Aapjedotinfo/esp32ct/hardware/esp32ct-revc/esp32ct-revc.pdf

1 | 2 | 3 | 4 | 5 | 6 | 7 | 8

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
Size: A3 | Rev: C | F Date: 2026-09-25
KiCad E.D.A. 10.0.6 | Id: 1/7

## Title: esp32ct rev C — Overzicht en ESP32

File: esp32ct-revc.kicad_sch

Sheet: /

Ontwerp. Basis: het huidige bord plus de wijzigingen van 22-09-2026.

Waarden met (?) zijn NIET van het bord afgelezen - zie OPEN PUNTEN.

Gegenereerd door gen_sch.py - pas dat script aan, niet dit bestand.

P1-uitgang naar laadpaal Bestand: p1_uit.kicad_sch Deurbel en watermeter Bestand: bel_water.kicad_sch P1 slimme meter Bestand: p1.kicad_sch CT-kanalen 1-16 Bestand: ct_kanalen.kicad_sch Multiplexer (HW-178) Bestand: mux.kicad_sch

Voeding en VBIAS Bestand: voeding.kicad_sch GND 1 | RST/EN 2 | NC 3

IO36/SVP 4
IO39/SVN 5
IO26 6
IO35/ADC1_7 7
IO18 8
IO33 9
IO19 10
IO34/ADC1_6 11
IO23 12
IO14 13
IO05 14 NC 15

3V3 16
IO09/SD2 17
IO13 18 CMD 19

IO10/SD3 20

TXD | 21 GND | 22 RXD | 23
IO27 | | 24
IO22 | | 25
IO25 | | 26
IO21 | | 27
IO32 | | 28
IO17 | | 29
IO12_(strap) | | 30
IO16 | | 31
IO04 | 32 GND | 33
IO00 | | 34
VCC_(USB) | | 35
IO02 | | 36
TD0 | | 37
SD1 | | 38
SD0 | 39 CLK | 40 U1MH-ET Live D1 mini ESP32 GND

GND WATER_PULS MUX_S1 BEL_IN

P1_RX BEL_HUIS

SIG_MUX1 P1_RTS MUX_S2 | P1OUT_RTS P1OUT_TX +3V3 | MUX_S3 BEL_GARAGE MUX_S0 | GND +5V

esp32ct rev C — 16 CT-kanalen, P1 in en uit, watermeter, deurbel ONTWERP. Basis is het huidige bord; de wijzigingen staan hieronder. De pinbezetting komt uit de draaiende firmware (esp32ct.yaml), met

twee wijzigingen: P1_RTS van GPIO19 naar GPIO23, en mux S1 van GPIO12 naar GPIO4. Nieuw zijn GPIO16 en GPIO17 voor de P1-uitgang. Geen strapping pins: GPIO0, 2, 5, 12 en 15 hangen nergens aan. Een hoge GPIO12 bij het opstarten zet de flash op 1,8 V en dan
start de module niet. WIJZIGINGEN t.o.v. het huidige bord - 16 CT-kanalen in plaats van 22; de tweede multiplexer vervalt. Die mat alleen de laadpaal en had een defecte VBIAS-rail. - de mux is een HW-178-breakout op twee female headers. - per kanaal een jumper IN SERIE met de burden, zodat een klem met eigen burden kan zonder de weerstand weg te knippen. - alles op schroefklem behalve de twee RJ12's. - de relais zitten op een los Arduino-relaisbordje (J4/J5). Die zijn actief-laag: de firmware heeft inverted: true nodig. - nieuw: P1-uitgang naar de laadpaal (blad 7). - P1_RTS op GPIO23 (was 19), mux S1 op GPIO4 (was 12). GPIO35 komt vrij.

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
## Title: esp32ct rev C — Voeding en VBIAS

File: voeding.kicad_sch

Sheet: /Voeding en VBIAS/

Ontwerp. Basis: het huidige bord plus de wijzigingen van 22-09-2026.

Waarden met (?) zijn NIET van het bord afgelezen - zie OPEN PUNTEN.

Gegenereerd door gen_sch.py - pas dat script aan, niet dit bestand.

F1
1A | C2
100n (?) 1

1

2

2

J1+5V | extern | R1
10k (?) | C1 100u (?)

#FLG1 PWR_FLAG

#FLG2 PWR_FLAG

R2

10k (?) | C3
10u (?) | 1OUT | 1
1IN- 2

1IN+ 3

V- 4

2IN+ 5

2IN- 6

2OUT | 7
V+ | 8 U2
LM358 +5V_IN | +5V GND | +5V +5V | GND | +5V +3V3 | GND | GND GND | GND
GND | +3V3

VBIAS

voedingsspanning van de opamp

niet nagekeken (?) | VBIAS — de middenrail van 1,65 V De CT's leveren wisselstroom. De ADC van de ESP32 kan alleen 0-3,3 V meten, dus wordt het hele signaal opgetild naar het midden van dat bereik. Elke burden-weerstand hangt met één been aan deze rail. Dat maakt VBIAS ook meteen de verdachte in het mux2-probleem: als de

rail de ingangen van mux2 niet bereikt, meet die mux niets zinnigs. De tweede opamp van de LM358 is ongebruikt. OPEN PUNTEN op dit blad - de deelweerstanden en condensatoren zijn NIET van het bord

afgelezen; 10k/10k geeft 1,65 V maar de echte waarden zijn onbekend - of de LM358 op 3,3 V of op 5 V staat is niet nagekeken - of de ongebruikte tweede opamp netjes is afgesloten is onbekend - de 5 V-buffercondensatoren zijn aangenomen, niet geteld

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
## Title: esp32ct rev C — Multiplexer (HW-178)

File: mux.kicad_sch

Sheet: /Multiplexer (HW-178)/

Ontwerp. Basis: het huidige bord plus de wijzigingen van 22-09-2026.

Waarden met (?) zijn NIET van het bord afgelezen - zie OPEN PUNTEN.

Gegenereerd door gen_sch.py - pas dat script aan, niet dit bestand.

C0 1 | C1 2 | C2 3 | C3 4 | C4 5 | C5 6 | C6 7 | C7 8 | C8 9 | C9 10 | C10 11 | C11 12 | C12 13 | C13 14 | C14 15 | C15 16
SIG | 17
EN | 18
S0 | 19
S1 | 20
S2 | 21
S3 | 22
VCC | 23 GND | 24 U3HW-178 (CD74HC4067) | MUX_S3 CT1 CT4 CT2 CT5 CT3 CT16 CT6 CT9 CT7 CT8

SIG_MUX1 GND

CT10 | MUX_S0 CT11 | MUX_S1 CT12 | MUX_S2 CT13 | +3V3 CT14 | GND

CT15

Een multiplexer, zestien kanalen - en dat is met opzet Het vorige bord had er twee, die samen de adreslijnen S0-S3 deelden. Dat werkte alleen met precies EEN cd74hc4067-hub in de firmware: bij twee hubs raakte de interne cache van elk van beide verouderd

zodra de ander schakelde, en landden metingen op een verkeerd (vaak zwevend) kanaal. Dat gaf fantoomwaardes van meerdere kW. De tweede mux is hier vervallen. Hij mat alleen de laadpaal, en die wordt voortaan aangestuurd via de nagebootste P1-uitgang op blad 7. Daarmee verdwijnt ook het VBIAS-probleem dat mux2 onbruikbaar maakte. GPIO35 komt daarmee vrij.

U3 is geen chip maar een VOETJE voor het HW-178-breakout Het breakout steekt plat met rechte pinnen in twee female strips: 1x16 voor C0-C15 en 1x8 voor SIG..GND, op 15,24 mm hart-op-hart. Maten uit SparkFun's BOB-09056, waar het HW-178 een kloon van is. De pinnummers van U3 zijn die van het voetje (footprint HW178_socket), NIET die van de CD74HC4067-chip. Zet hier nooit een DIP- of SOIC-footprint onder: dan klopt geen pin en hangt VCC aan GND. EN ligt vast aan massa: de mux staat permanent aan.

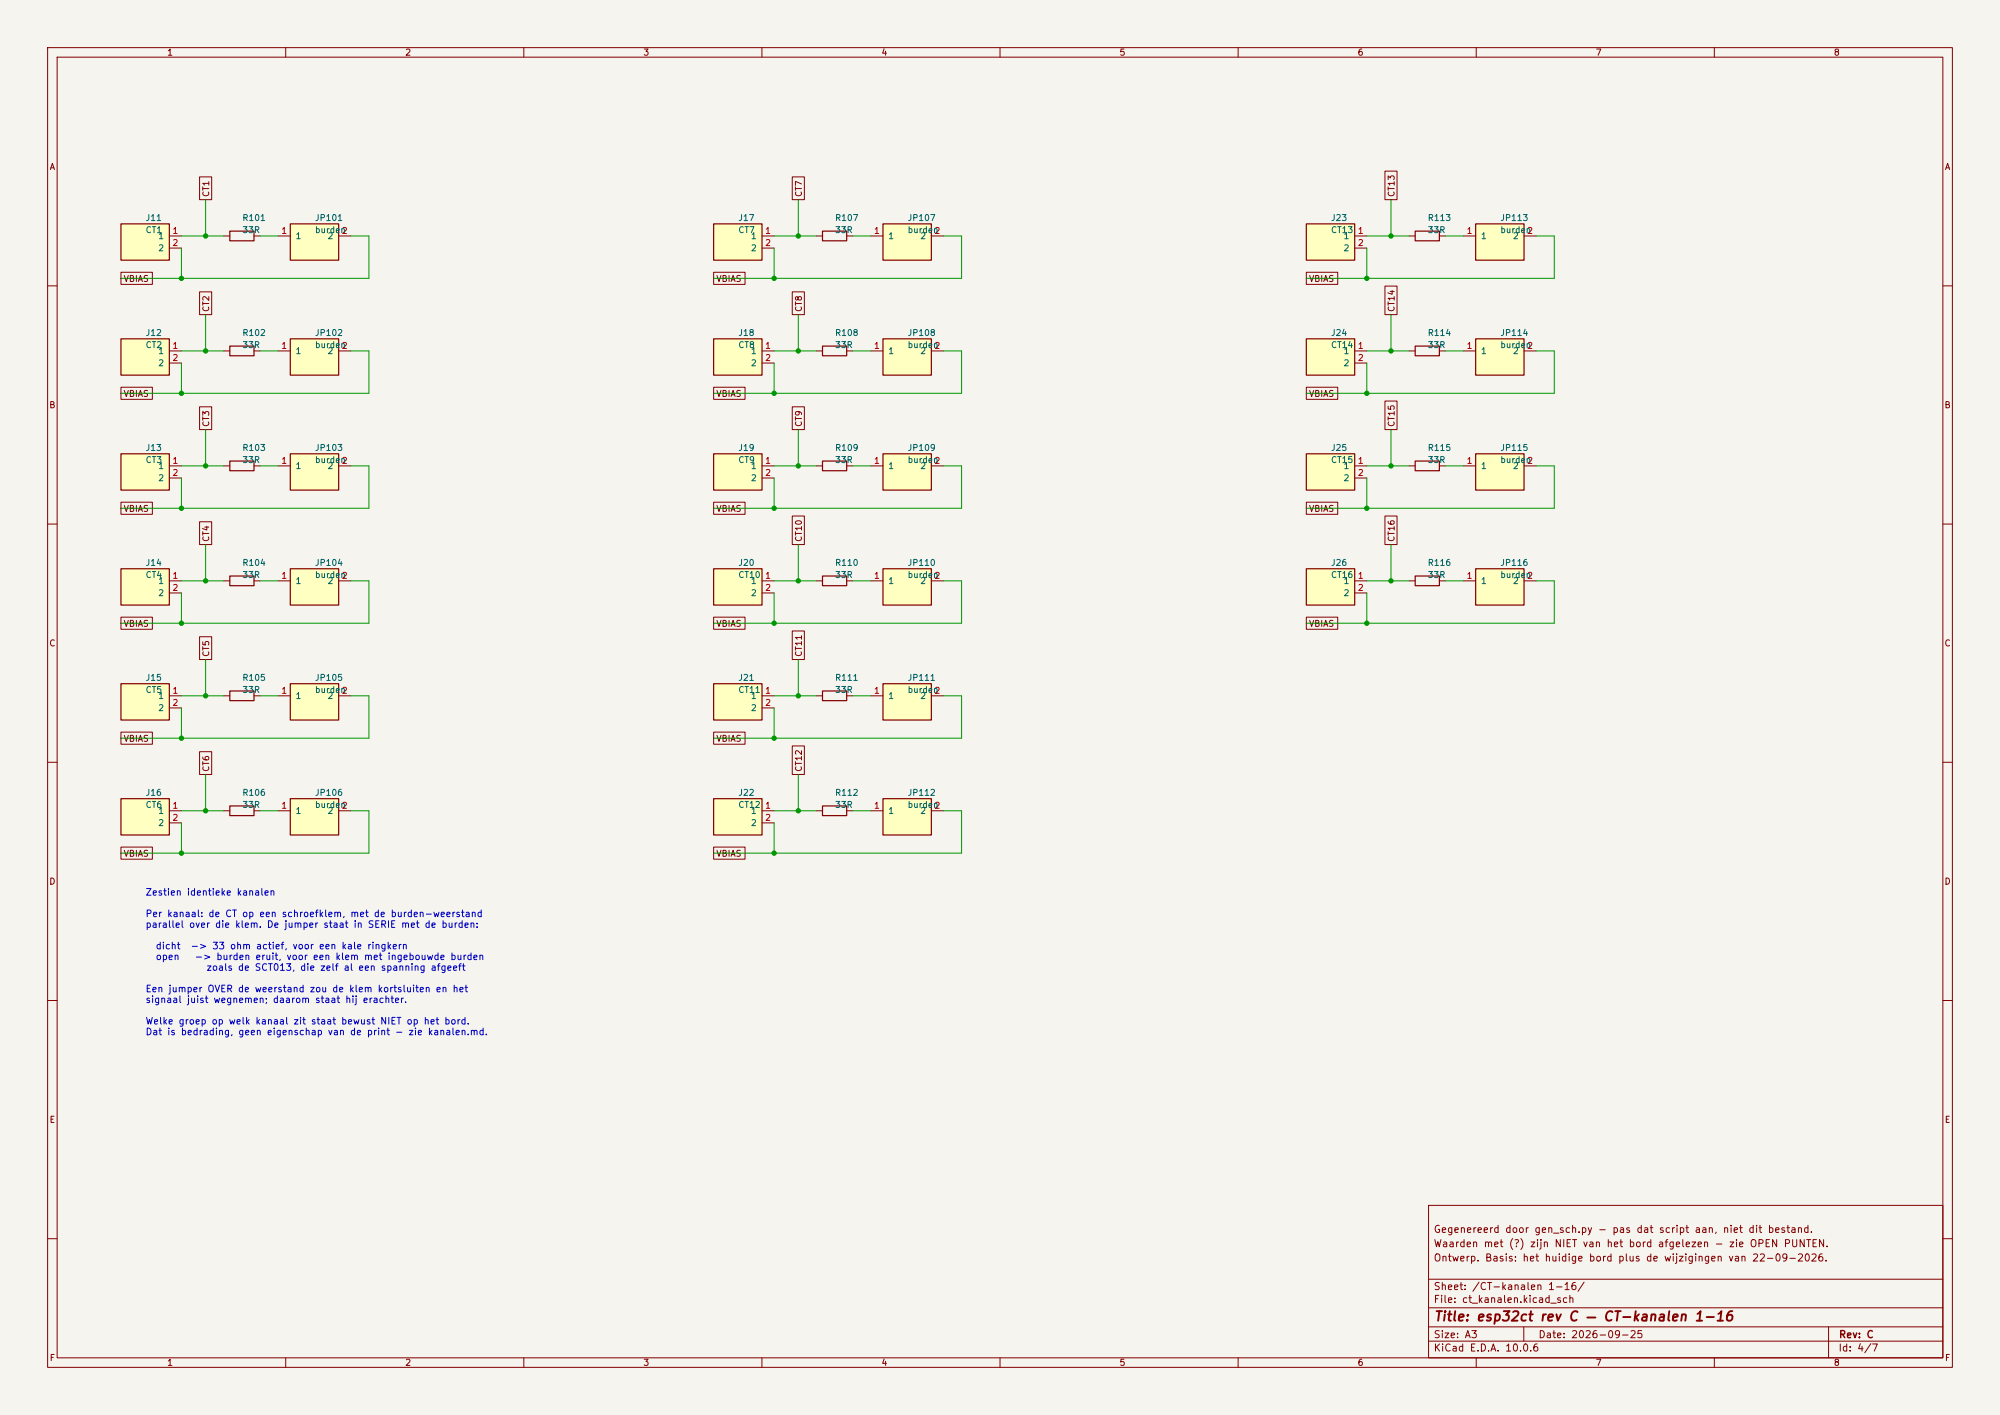
[picture p5: page 4]

Zestien identieke kanalen Per kanaal: de CT op een schroefklem, met de burden-weerstand

parallel over die klem. De jumper staat in SERIE met de burden: dicht -> 33 ohm actief, voor een kale ringkern

zoals de SCT013, die zelf al een spanning afgeeft Een jumper OVER de weerstand zou de klem kortsluiten en het signaal juist wegnemen; daarom staat hij erachter. Welke groep op welk kanaal zit staat bewust NIET op het bord. Dat is bedrading, geen eigenschap van de print - zie kanalen.md.

Gegenereerd door gen_sch.py - pas dat script aan, niet dit bestand.
Waarden met (?) zijn NIET van het bord afgelezen - zie OPEN PUNTEN.
Ontwerp. Basis: het huidige bord plus de wijzigingen van 22-09-2026.

Sheet: /CT-kanalen 1-16/
File: ct_kanalen.kicad_sch
Title: esp32ct rev C — CT-kanalen 1-16

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
## Title: esp32ct rev C — P1 slimme meter

File: p1.kicad_sch

Sheet: /P1 slimme meter/

Ontwerp. Basis: het huidige bord plus de wijzigingen van 22-09-2026.

Waarden met (?) zijn NIET van het bord afgelezen - zie OPEN PUNTEN.

Gegenereerd door gen_sch.py - pas dat script aan, niet dit bestand.

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
J2RJ12 naar slimme meter | R3
10k (?) | C

1 B

2

E | 3 Q1BC547 | (?) | R4

10k (?) P1_RTS GND

P1_DATA GND

P1_DATA | GND | +3V3 | P1_RX | P1-poort van de slimme meter De meter zendt inverted TTL op een open-collector uitgang. Een NPN
| | | | draait het signaal om en tilt het naar 3,3 V, zodat de UART van de ESP32 het kan lezen (GPIO18).
| | | | P1_RTS (GPIO23) vraagt de meter om te zenden: hoog is elke seconde een telegram. De firmware heeft dit als request_pin. OPEN PUNTEN op dit blad - de inverter is de gangbare schakeling, maar het type transistor en de weerstandswaarden zijn NIET van het bord afgelezen - of P1_RTS rechtstreeks aan GPIO23 mag of via een

niveauomzetter naar 5 V, is niet nagekeken - of de meter het bord voedt via RJ12 pin 1 is niet nagekeken; hier is uitgegaan van de externe 5 V op J1

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
## Title: esp32ct rev C — Deurbel en watermeter

File: bel_water.kicad_sch

Sheet: /Deurbel en watermeter/

Ontwerp. Basis: het huidige bord plus de wijzigingen van 22-09-2026.

Waarden met (?) zijn NIET van het bord afgelezen - zie OPEN PUNTEN.

Gegenereerd door gen_sch.py - pas dat script aan, niet dit bestand.

1

1

2

2

J4
naar relaisbordje

R18
10k 1

1

2

2

J3watermeter-sensor 1

1

2

2

J9watermeter-sensor

1

1

2

2

J6

# deurbelknop 1

1

2

2

J5
naar | relaisbordje +5V WATER_PULS GND
GND | +3V3 WATER_PULS

# GND +5V GND

BEL_HUIS BEL_GARAGE BEL_IN Deurbel De relais zitten niet meer op dit bord. J4 en J5 gaan met vier draden

naar een standaard Arduino-relaisbordje met twee kanalen: J4-1 +5V | -> VCC van het relaisbordje
J4-2 GND | -> GND
J5-1 BEL1 (huis) | GPIO33 -> IN1
J5-2 BEL2 (garage) GPIO25 -> IN2 De beltrafo (6 V AC) en de twee bellen komen op de schroefklemmen van

dat relaisbordje: trafo naar COM van beide relais, NO naar de bel, en
de retour van beide bellen rechtstreeks terug naar de trafo. De deurbelknop (J6) blijft hier: een gewoon maakcontact in de deur, dat rechtstreeks aan GPIO26 hangt met de interne pull-up. Watermeter: inductieve naderingsschakelaar, 5 Vdc NPN, normally open, 4 mm schakelafstand. Bruin = +5 V, blauw = GND, zwart = de open-collector uitgang (op J3 pin 2). R18 trekt de uitgang op naar 3,3 V. Omdat de sensor alleen naar massa schakelt, komt er nooit 5 V op GPIO32 - een deler is dus niet nodig. De sensor zelf draait wel op 5 V. De firmware gooit sinds 14-09-2026 alles boven 30 L/min weg; dat ving een klapperende sensor af, geen hardwarewijziging.

LET OP - de firmware moet mee veranderen De gangbare relaisbordjes zijn ACTIEF-LAAG: het relais komt op als IN

naar massa gaat. In esp32ct.yaml staan de switches op GPIO33 en GPIO25 nu zonder inverted, en een ESP32-pin is laag tijdens het opstarten. Zonder inverted: true gaat de bel dus bij elke reboot. En: de logicakant van zo'n bordje hangt aan 5 V, de ESP32 stuurt maar 3,3 V. Test of het relais netjes afvalt als IN op 3,3 V staat. Blijft het hangen of klappert het, voed dan VCC van het relaisbordje uit 3,3 V en de spoelen (JD-VCC) uit 5 V.

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
## Title: esp32ct rev C — P1-uitgang naar laadpaal

File: p1_uit.kicad_sch

Sheet: /P1-uitgang naar laadpaal/

Ontwerp. Basis: het huidige bord plus de wijzigingen van 22-09-2026.

Waarden met (?) zijn NIET van het bord afgelezen - zie OPEN PUNTEN.

Gegenereerd door gen_sch.py - pas dat script aan, niet dit bestand.

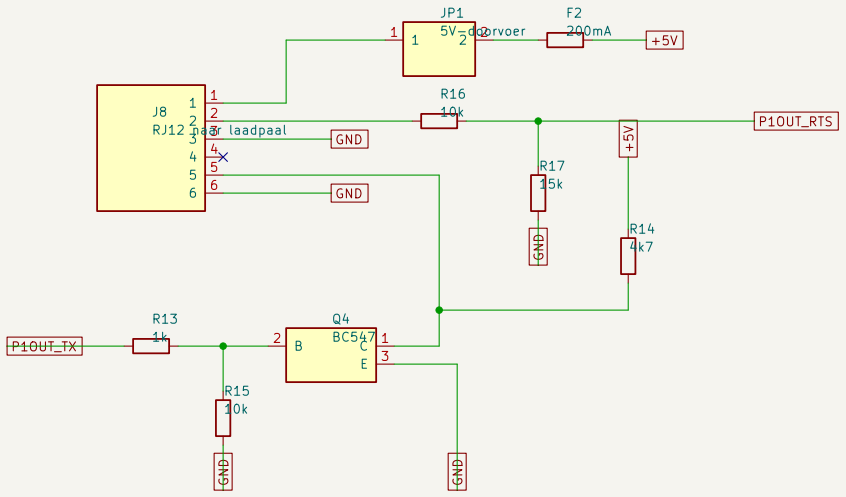
[picture p6: figure]
J8RJ12 naar laadpaal; JP1 5V-doorvoer R15; GND; P1OUT_RTS GND; +5V GND

P1OUT_TX | GND | OPEN PUNTEN - GPIO16/17 zijn gekozen omdat ze vrij zijn en UART2 vormen. Controleer of ze op jouw MiniKit ook echt naar buiten zijn gebracht. - of de laadpaal de 5 V van pin 1 nodig heeft is niet nagegaan; JP1

laat je die keuze open. - alle weerstandswaarden zijn ontwerpkeuzes, geen meting.

Waarom een transistor en geen rechtstreekse pin De P1-datalijn is geinverteerd en werkt op 5 V met een open

collector: in rust ligt de lijn LAAG en de pull-up trekt hem hoog
voor elke bit. Een ESP32-pin kan dat niet: 3,3 V is te laag en de polariteit klopt niet. Q4 lost beide op. De UART van de ESP32 zendt gewoon normaal - rust is hoog - en de transistor draait dat om terwijl R14 de lijn naar 5 V tilt. Dezelfde truc als op blad 6, alleen de andere kant op. R15 houdt de basis laag zolang de UART nog niet is opgestart, zodat de lijn niet willekeurig gaat zwaaien tijdens het booten. NIEUW - nog niet gebouwd

Een tweede P1-poort, maar dan andersom: dit bord speelt hier zelf voor slimme meter, zodat de laadpaal op een zelfbedacht vermogen

kan loadbalancen. Handig om hem te laten denken dat er 35 kW door de aansluiting gaat en hij dus moet terugregelen. Blad 6 is de ingang vanaf de echte meter; dit blad is de uitgang. Wat de firmware nog moet doen - UART2 op GPIO17 (TX), 115200 8N1 voor DSMR 5. Niet inverted in de

software: Q4 doet de inversie al in hardware. - zelf een telegram opbouwen en afsluiten met CRC16 over alles vanaf de / tot en met de !, anders verwerpt de laadpaal het. - GPIO16 leest of de laadpaal om data vraagt. Mag je negeren en

gewoon elke seconde zenden; dan is R16/R17 optioneel. Controleer voor je gaat solderen of de laadpaal DSMR 5 (115200 8N1) verwacht of het oudere DSMR 2/3 (9600 7E1) - dat scheelt alleen

firmware, de schakeling blijft hetzelfde.
