Aapjedotinfo/esp32ct/hardware/esp32ct-revc/render_bottom.png

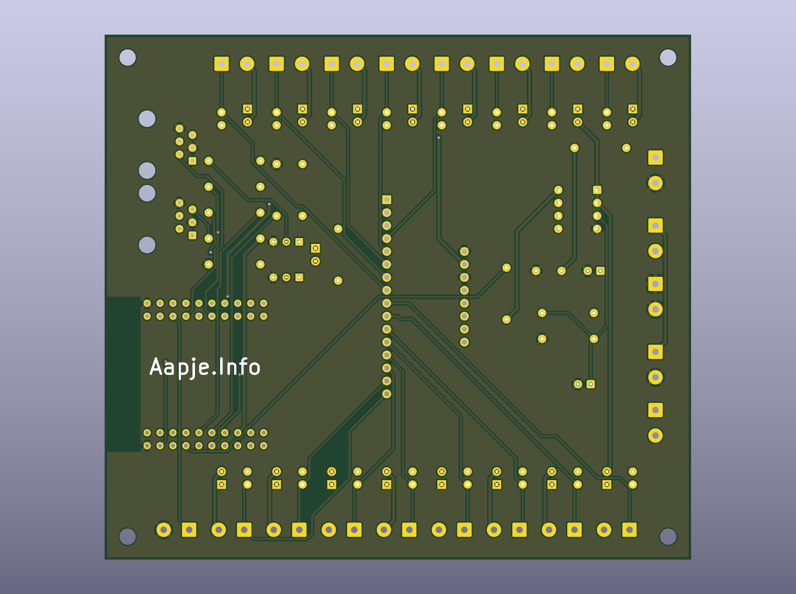
hardware/esp32ct-revc/render_bottom.png
