Aapjedotinfo/esp32ct/hardware/esp32ct-asbuilt/bom.csv

Reference | Value | Description | Footprint
C1 | 100u (?)
C2 | 100n (?)
C3 | 10u (?) | dempt de middenrail
D1,D3 | 1N4007 | vrijloopdiode over de relaisspoel
D2,D4 | relais aan
J1 | +5V extern | externe 5 V voeding van het bord | TerminalBlock:TerminalBlock_MaiXu_MX126-5.0-02P_1x02_P5.00mm
J2 | RJ12 naar slimme meter | P1-poort, DSMR 5
J3,J9 | watermeter-sensor | pulssensor op de watermeter | TerminalBlock:TerminalBlock_MaiXu_MX126-5.0-02P_1x02_P5.00mm
J4 | Bel 1 (huis) |  | TerminalBlock:TerminalBlock_MaiXu_MX126-5.0-02P_1x02_P5.00mm
J5 | Bel 2 (garage) |  | TerminalBlock:TerminalBlock_MaiXu_MX126-5.0-02P_1x02_P5.00mm
J6 | deurbelknop | maakcontact in de deur, potentiaalvrij | TerminalBlock:TerminalBlock_MaiXu_MX126-5.0-02P_1x02_P5.00mm
J7 | beltrafo 6 V AC | voedt de bellen, geschakeld door K1/K2 | TerminalBlock:TerminalBlock_MaiXu_MX126-5.0-02P_1x02_P5.00mm
J8 | RJ12 naar laadpaal | NIEUW - nagebootste P1-poort, nog niet gebouwd
J11 | CT1 | GTA20L1.0 ring 1000:1 | TerminalBlock:TerminalBlock_MaiXu_MX126-5.0-02P_1x02_P5.00mm
J12 | CT2 | GTA20L1.0 ring 1000:1 | TerminalBlock:TerminalBlock_MaiXu_MX126-5.0-02P_1x02_P5.00mm
J13 | CT3 | GTA20L1.0 ring 1000:1 | TerminalBlock:TerminalBlock_MaiXu_MX126-5.0-02P_1x02_P5.00mm
J14 | CT4 | GTA20L1.0 ring 1000:1 | TerminalBlock:TerminalBlock_MaiXu_MX126-5.0-02P_1x02_P5.00mm
J15 | CT5 | GTA20L1.0 ring 1000:1 | TerminalBlock:TerminalBlock_MaiXu_MX126-5.0-02P_1x02_P5.00mm
J16 | CT6 | GTA20L1.0 ring 1000:1 | TerminalBlock:TerminalBlock_MaiXu_MX126-5.0-02P_1x02_P5.00mm
J17 | CT7 | GTA20L1.0 ring 1000:1 | TerminalBlock:TerminalBlock_MaiXu_MX126-5.0-02P_1x02_P5.00mm
J18 | CT8 | GTA20L1.0 ring 1000:1 | TerminalBlock:TerminalBlock_MaiXu_MX126-5.0-02P_1x02_P5.00mm
J19 | CT9 | GTA20L1.0 ring 1000:1 | TerminalBlock:TerminalBlock_MaiXu_MX126-5.0-02P_1x02_P5.00mm
J20 | CT10 | GTA20L1.0 ring 1000:1 | TerminalBlock:TerminalBlock_MaiXu_MX126-5.0-02P_1x02_P5.00mm
J21 | CT11 | GTA20L1.0 ring 1000:1 | TerminalBlock:TerminalBlock_MaiXu_MX126-5.0-02P_1x02_P5.00mm
J22 | CT12 | GTA20L1.0 ring 1000:1 | TerminalBlock:TerminalBlock_MaiXu_MX126-5.0-02P_1x02_P5.00mm
J23 | CT13 | GTA20L1.0 ring 1000:1 | TerminalBlock:TerminalBlock_MaiXu_MX126-5.0-02P_1x02_P5.00mm
J24 | CT14 | GTA20L1.0 ring 1000:1 | TerminalBlock:TerminalBlock_MaiXu_MX126-5.0-02P_1x02_P5.00mm
J25 | CT15 | GTA20L1.0 ring 1000:1 | TerminalBlock:TerminalBlock_MaiXu_MX126-5.0-02P_1x02_P5.00mm
J26 | CT16 | GTA20L1.0 ring 1000:1 | TerminalBlock:TerminalBlock_MaiXu_MX126-5.0-02P_1x02_P5.00mm
J27 | CT17 | GTA20L1.0 ring 1000:1 | TerminalBlock:TerminalBlock_MaiXu_MX126-5.0-02P_1x02_P5.00mm
J28 | CT18 | GTA20L1.0 ring 1000:1 | TerminalBlock:TerminalBlock_MaiXu_MX126-5.0-02P_1x02_P5.00mm
J29 | CT19 | GTA20L1.0 ring 1000:1 | TerminalBlock:TerminalBlock_MaiXu_MX126-5.0-02P_1x02_P5.00mm
J30 | CT20 | SCT013-015 15A/1V | TerminalBlock:TerminalBlock_MaiXu_MX126-5.0-02P_1x02_P5.00mm
J31 | CT21 | SCT013-015 15A/1V | TerminalBlock:TerminalBlock_MaiXu_MX126-5.0-02P_1x02_P5.00mm
J32 | CT22 | SCT013-015 15A/1V | TerminalBlock:TerminalBlock_MaiXu_MX126-5.0-02P_1x02_P5.00mm
JP1 | 5V-doorvoer | open laten als de laadpaal zichzelf voedt
K1,K2 | SRD-05VDC-SL-C | 6 V AC van de beltrafo naar de bel
Q1 | BC547 (?) | inverteert het open-collector datasignaal van de meter
Q2,Q3 | S8050 | schakelt de relaisspoel
Q4 | BC547 | maakt het geinverteerde open-collector signaal
R1 | 10k (?) | bovenste helft van de 1,65 V deler
R2 | 10k (?) | onderste helft van de 1,65 V deler
R3,R4 | 10k (?)
R5,R6,R8,R9,R11-R13 | 1k
R7,R10 | 10k | houdt de basis laag als de opto niet geleidt
R14 | 4k7 | pull-up; bij 115200 baud niet hoger kiezen
R15 | 10k | houdt de basis laag als de ESP32 nog niet zendt
R16 | 10k
R17 | 15k | onderste helft van de 5V->3V3 deler
R101-R119 | 33R | burden 33R -> 0,033 V/A theoretisch, 0,0307 V/A gefit
R120-R122 | 33R (weggeknipt) | burden weggeknipt: SCT013 heeft een ingebouwde burden
U1 | MH-ET Live D1 mini ESP32 | ESP32-WROOM-32, 4 MB flash | esp32ct:ESP32_mini
U2 | LM358 | opamp als spanningsvolger op de 1,65 V middenrail | Package_DIP:DIP-8_W7.62mm
U3 | CD74HC4067 | 16-kanaals analoge multiplexer, kanalen 1-16 | Package_DIP:DIP-24_W7.62mm
U4 | CD74HC4067 | 16-kanaals analoge multiplexer, kanalen 17-22 | Package_DIP:DIP-24_W7.62mm
U5,U6 | PC817 | galvanische scheiding tussen ESP32 en de relaistrap | Package_DIP:DIP-4_W7.62mm
