Aapjedotinfo/esp32ct/hardware/esp32ct-revc/bom.csv

Reference | Value | Description | Footprint
C1 | 100u (?) |  | Capacitor_THT:CP_Radial_D6.3mm_P2.50mm
C2 | 100n (?) |  | Capacitor_THT:C_Disc_D5.0mm_W2.5mm_P5.00mm
C3 | 10u (?) | dempt de middenrail | Capacitor_THT:CP_Radial_D6.3mm_P2.50mm
F1 | 1A | zekering 1 A traag, axiaal; of een 0 ohm-brug | Resistor_THT:R_Axial_DIN0207_L6.3mm_D2.5mm_P10.16mm_Horizontal
F2 | 200mA | zekering 200 mA naar de laadpaal, axiaal; of een 0 ohm-brug | Resistor_THT:R_Axial_DIN0207_L6.3mm_D2.5mm_P10.16mm_Horizontal
J1 | +5V extern | externe 5 V voeding van het bord | esp32ct:MX126_2P_5mm_krap
J2 | RJ12 naar slimme meter | P1-poort, DSMR 5 | Connector_RJ:RJ12_Amphenol_54601-x06_Horizontal
J3,J9 | watermeter-sensor | pulssensor op de watermeter | esp32ct:MX126_2P_5mm_krap
J4 | naar relaisbordje | voeding van het relaisbordje (VCC/GND) | esp32ct:MX126_2P_5mm_krap
J5 | naar relaisbordje | stuurlijnen naar IN1/IN2 | esp32ct:MX126_2P_5mm_krap
J6 | deurbelknop | maakcontact in de deur, potentiaalvrij | esp32ct:MX126_2P_5mm_krap
J8 | RJ12 naar laadpaal | NIEUW - nagebootste P1-poort, nog niet gebouwd | Connector_RJ:RJ12_Amphenol_54601-x06_Horizontal
J11 | CT1 | CT-klem of ringkern | esp32ct:MX126_2P_5mm_krap
J12 | CT2 | CT-klem of ringkern | esp32ct:MX126_2P_5mm_krap
J13 | CT3 | CT-klem of ringkern | esp32ct:MX126_2P_5mm_krap
J14 | CT4 | CT-klem of ringkern | esp32ct:MX126_2P_5mm_krap
J15 | CT5 | CT-klem of ringkern | esp32ct:MX126_2P_5mm_krap
J16 | CT6 | CT-klem of ringkern | esp32ct:MX126_2P_5mm_krap
J17 | CT7 | CT-klem of ringkern | esp32ct:MX126_2P_5mm_krap
J18 | CT8 | CT-klem of ringkern | esp32ct:MX126_2P_5mm_krap
J19 | CT9 | CT-klem of ringkern | esp32ct:MX126_2P_5mm_krap
J20 | CT10 | CT-klem of ringkern | esp32ct:MX126_2P_5mm_krap
J21 | CT11 | CT-klem of ringkern | esp32ct:MX126_2P_5mm_krap
J22 | CT12 | CT-klem of ringkern | esp32ct:MX126_2P_5mm_krap
J23 | CT13 | CT-klem of ringkern | esp32ct:MX126_2P_5mm_krap
J24 | CT14 | CT-klem of ringkern | esp32ct:MX126_2P_5mm_krap
J25 | CT15 | CT-klem of ringkern | esp32ct:MX126_2P_5mm_krap
J26 | CT16 | CT-klem of ringkern | esp32ct:MX126_2P_5mm_krap
JP1 | 5V-doorvoer | open laten als de laadpaal zichzelf voedt | Connector_PinHeader_2.54mm:PinHeader_1x02_P2.54mm_Vertical
JP101-JP116 | burden | dicht: burden actief. open: klem heeft eigen burden | Connector_PinHeader_2.54mm:PinHeader_1x02_P2.54mm_Vertical
Q1 | BC547 (?) | inverteert het open-collector datasignaal van de meter | Package_TO_SOT_THT:TO-92_Inline_Wide
Q4 | BC547 | maakt het geinverteerde open-collector signaal | Package_TO_SOT_THT:TO-92_Inline_Wide
R1 | 10k (?) | bovenste helft van de 1,65 V deler | Resistor_THT:R_Axial_DIN0207_L6.3mm_D2.5mm_P10.16mm_Horizontal
R2 | 10k (?) | onderste helft van de 1,65 V deler | Resistor_THT:R_Axial_DIN0207_L6.3mm_D2.5mm_P10.16mm_Horizontal
R3,R4 | 10k (?) |  | Resistor_THT:R_Axial_DIN0207_L6.3mm_D2.5mm_P10.16mm_Horizontal
R13 | 1k |  | Resistor_THT:R_Axial_DIN0207_L6.3mm_D2.5mm_P10.16mm_Horizontal
R14 | 4k7 | pull-up; bij 115200 baud niet hoger kiezen | Resistor_THT:R_Axial_DIN0207_L6.3mm_D2.5mm_P10.16mm_Horizontal
R15 | 10k | houdt de basis laag als de ESP32 nog niet zendt | Resistor_THT:R_Axial_DIN0207_L6.3mm_D2.5mm_P10.16mm_Horizontal
R16 | 10k |  | Resistor_THT:R_Axial_DIN0207_L6.3mm_D2.5mm_P10.16mm_Horizontal
R17 | 15k | onderste helft van de 5V->3V3 deler | Resistor_THT:R_Axial_DIN0207_L6.3mm_D2.5mm_P10.16mm_Horizontal
R18 | 10k | pull-up watermeterpuls naar 3,3 V | Resistor_THT:R_Axial_DIN0207_L6.3mm_D2.5mm_P10.16mm_Horizontal
R101-R116 | 33R | burden 33R -> 0,033 V/A theoretisch, 0,0307 V/A gefit | Resistor_THT:R_Axial_DIN0207_L6.3mm_D2.5mm_P2.54mm_Vertical
U1 | MH-ET Live D1 mini ESP32 | ESP32-WROOM-32, 4 MB flash | esp32ct:ESP32_mini
U2 | LM358 | opamp als spanningsvolger op de 1,65 V middenrail | Package_DIP:DIP-8_W7.62mm
U3 | HW-178 (CD74HC4067) | voetje voor het HW-178-breakout, plat op twee female headers | esp32ct:HW178_socket
