Aapjedotinfo/esp32ct/3dhouse/PCB Holder v5.stl

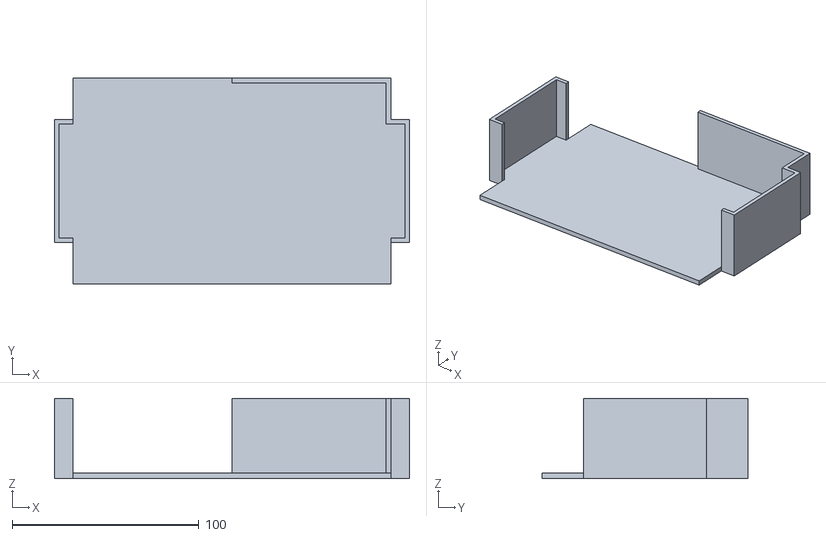
[picture p8: CAD file, 2026-10-31]
3dhouse/PCB Holder v5.stl
190.0 x 110.0 x 43.0
