Aapjedotinfo/esp32ct/3dhouse/ESP32CT_PCB_houder_R13_kastgaten.step

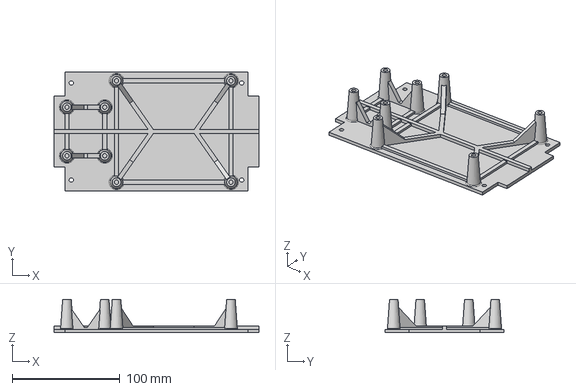
[picture p9: CAD file, 2026-10-31]
3dhouse/ESP32CT_PCB_houder_R13_kastgaten.step
190.0 x 110.0 x 31.0 mm
