Aapjedotinfo/esp32ct/(list of files, cad)

Other CAD files:
3dhouse/ESP32CT_PCB_houder_R13_kastgaten.f3d
3dhouse/ESP32CT_PCB_houder_R13_kastgaten.stl
