Aapjedotinfo/esp32ct/hardware/esp32ct-asbuilt/esp32ct-asbuilt.pdf

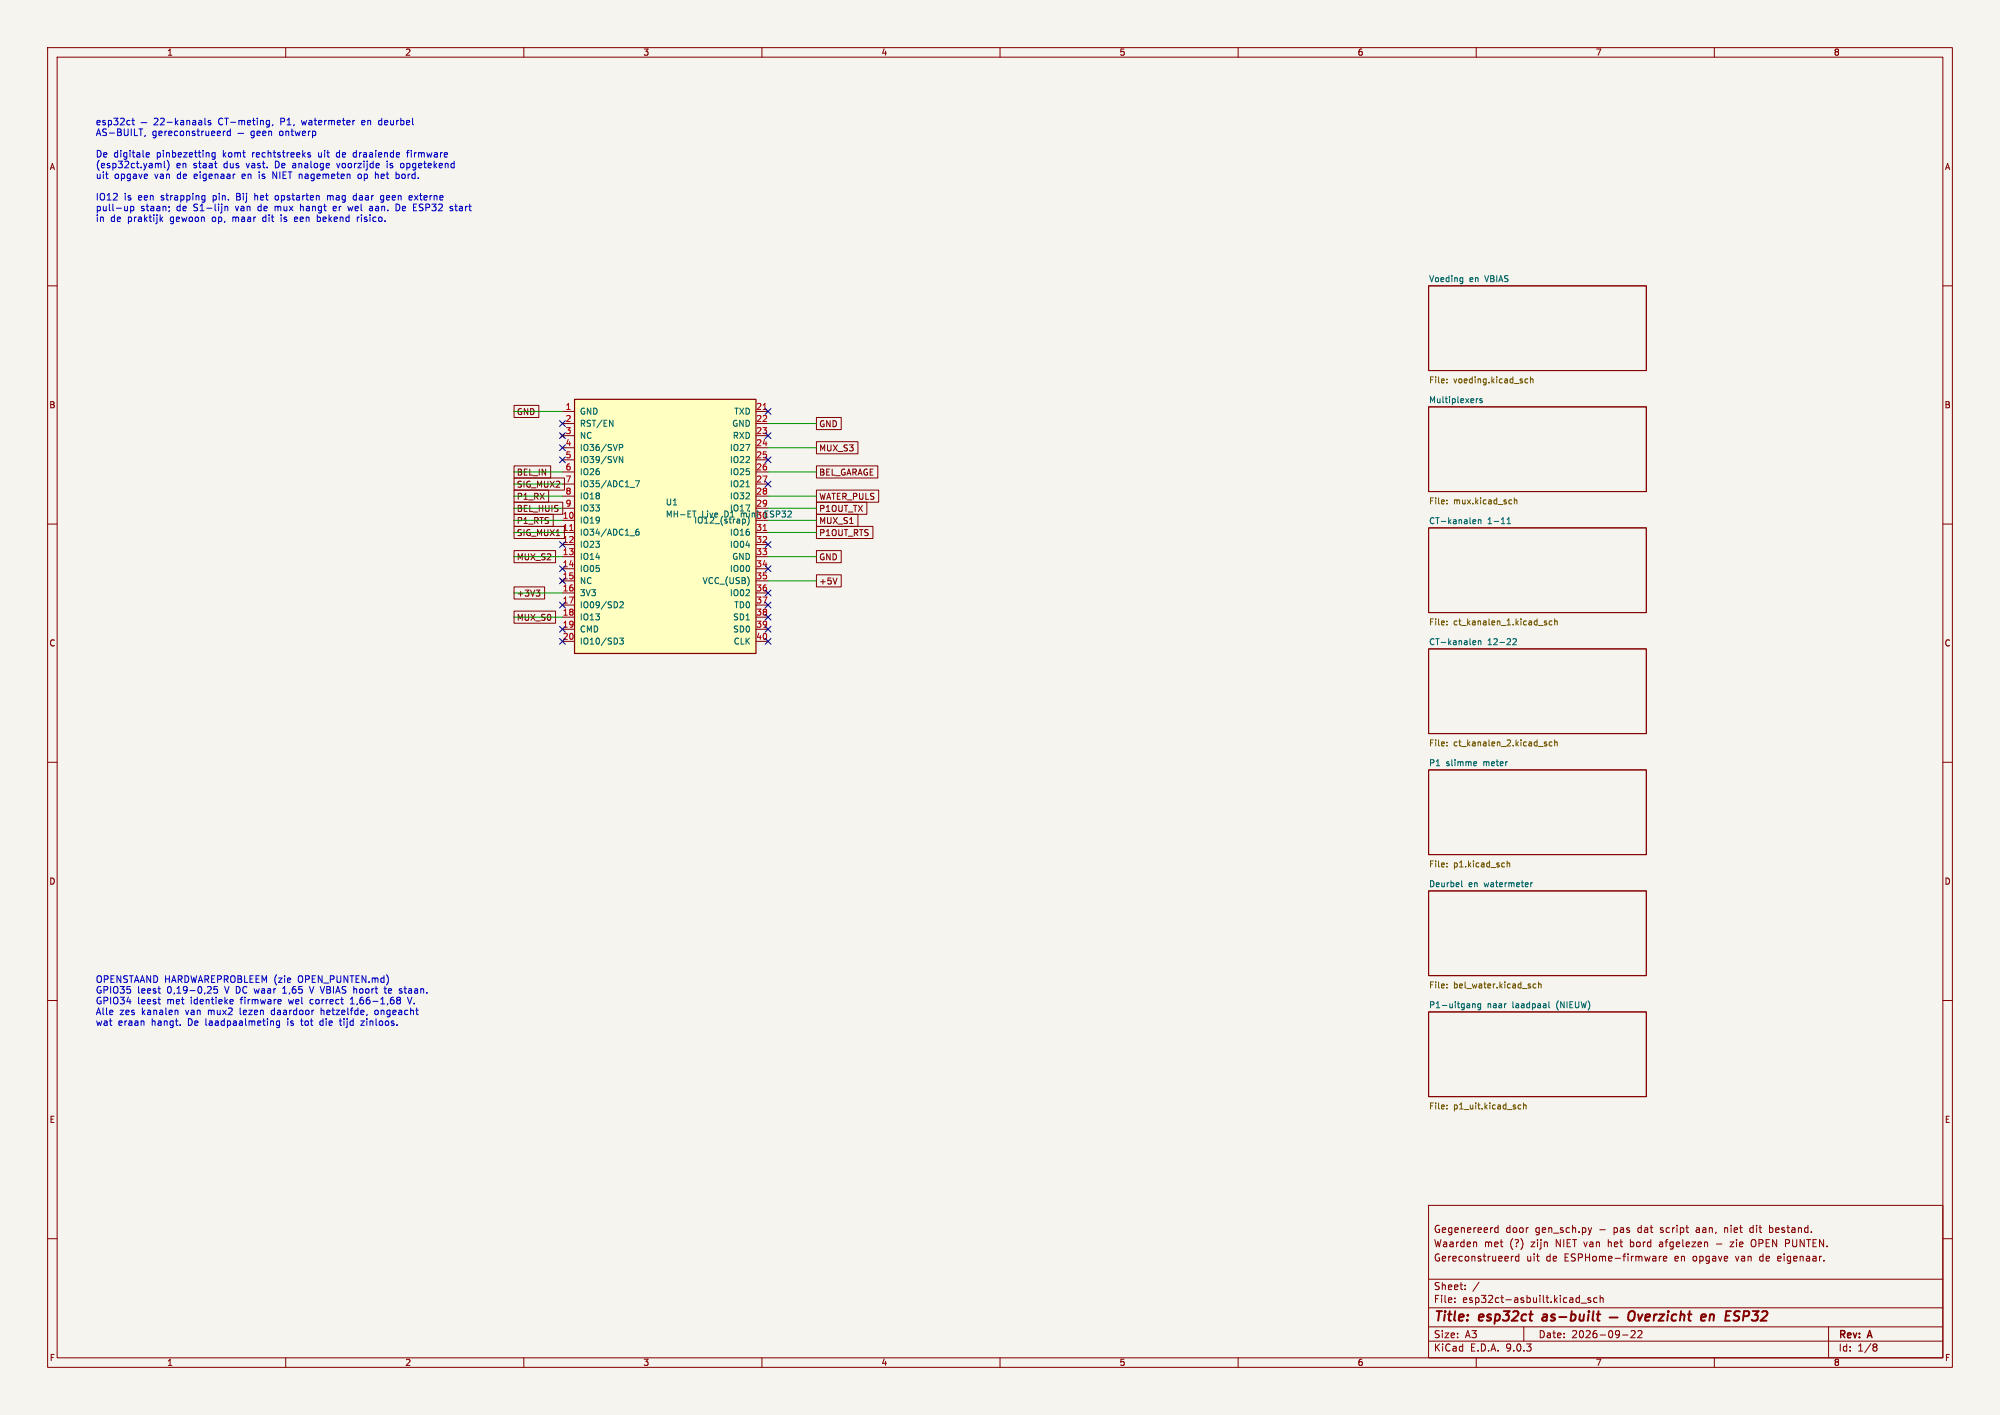
[picture p10: page 1]

Multiplexers File: mux.kicad_sch Voeding en VBIAS
File: voeding.kicad_sch P1 slimme meter File: p1.kicad_sch Deurbel en watermeter File: bel_water.kicad_sch

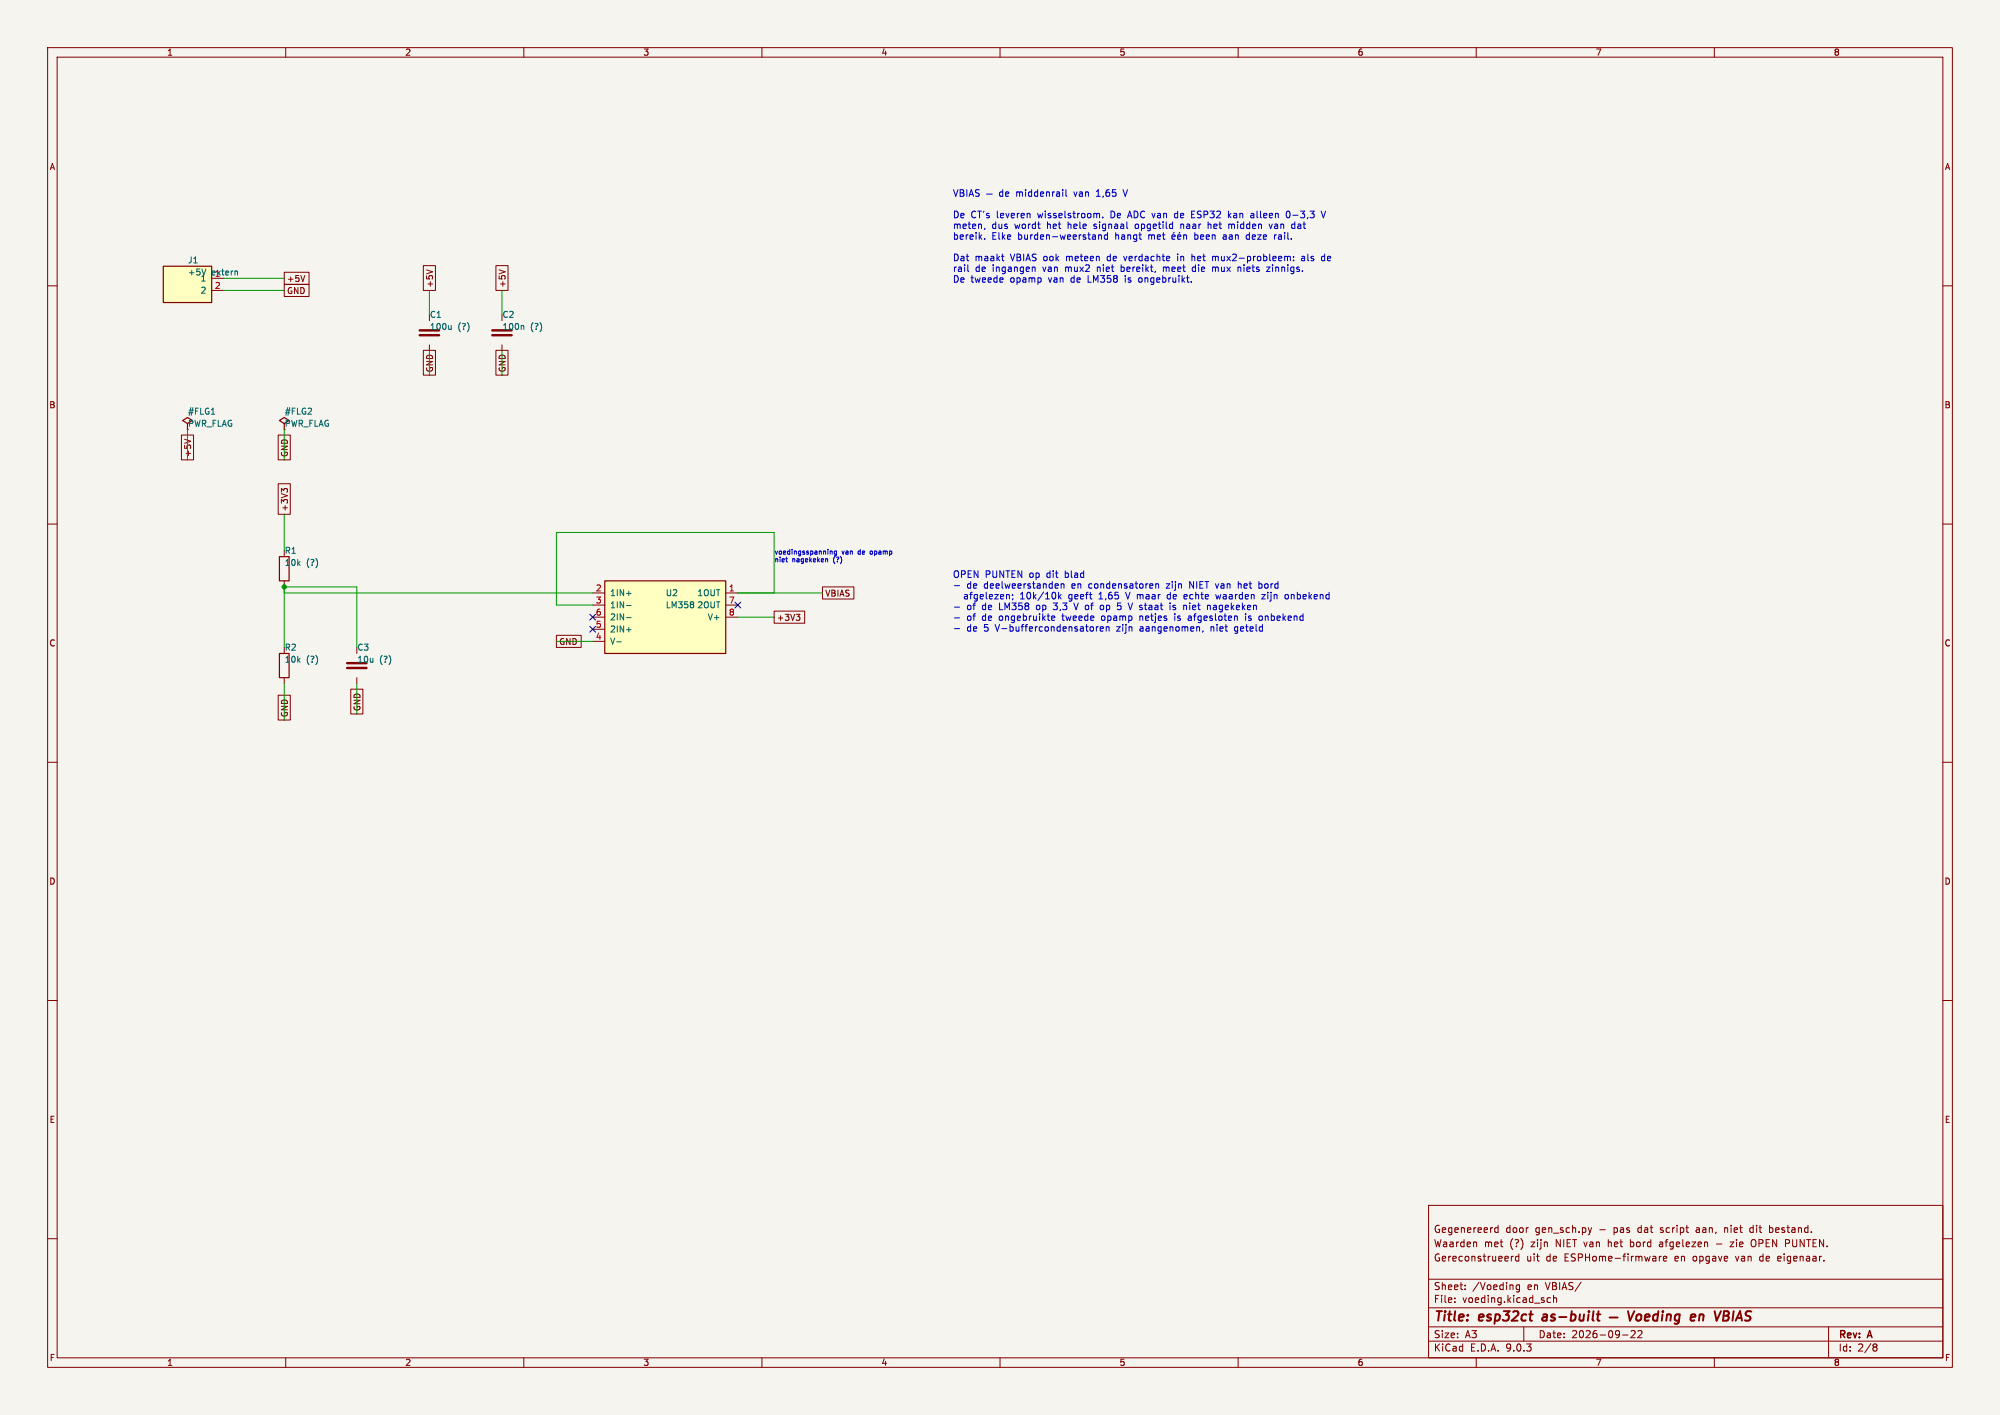
[picture p11: page 2]

rail de ingangen van mux2 niet bereikt, meet die mux niets zinnigs. De tweede opamp van de LM358 is ongebruikt. OPEN PUNTEN op dit blad

- of de LM358 op 3,3 V of op 5 V staat is niet nagekeken

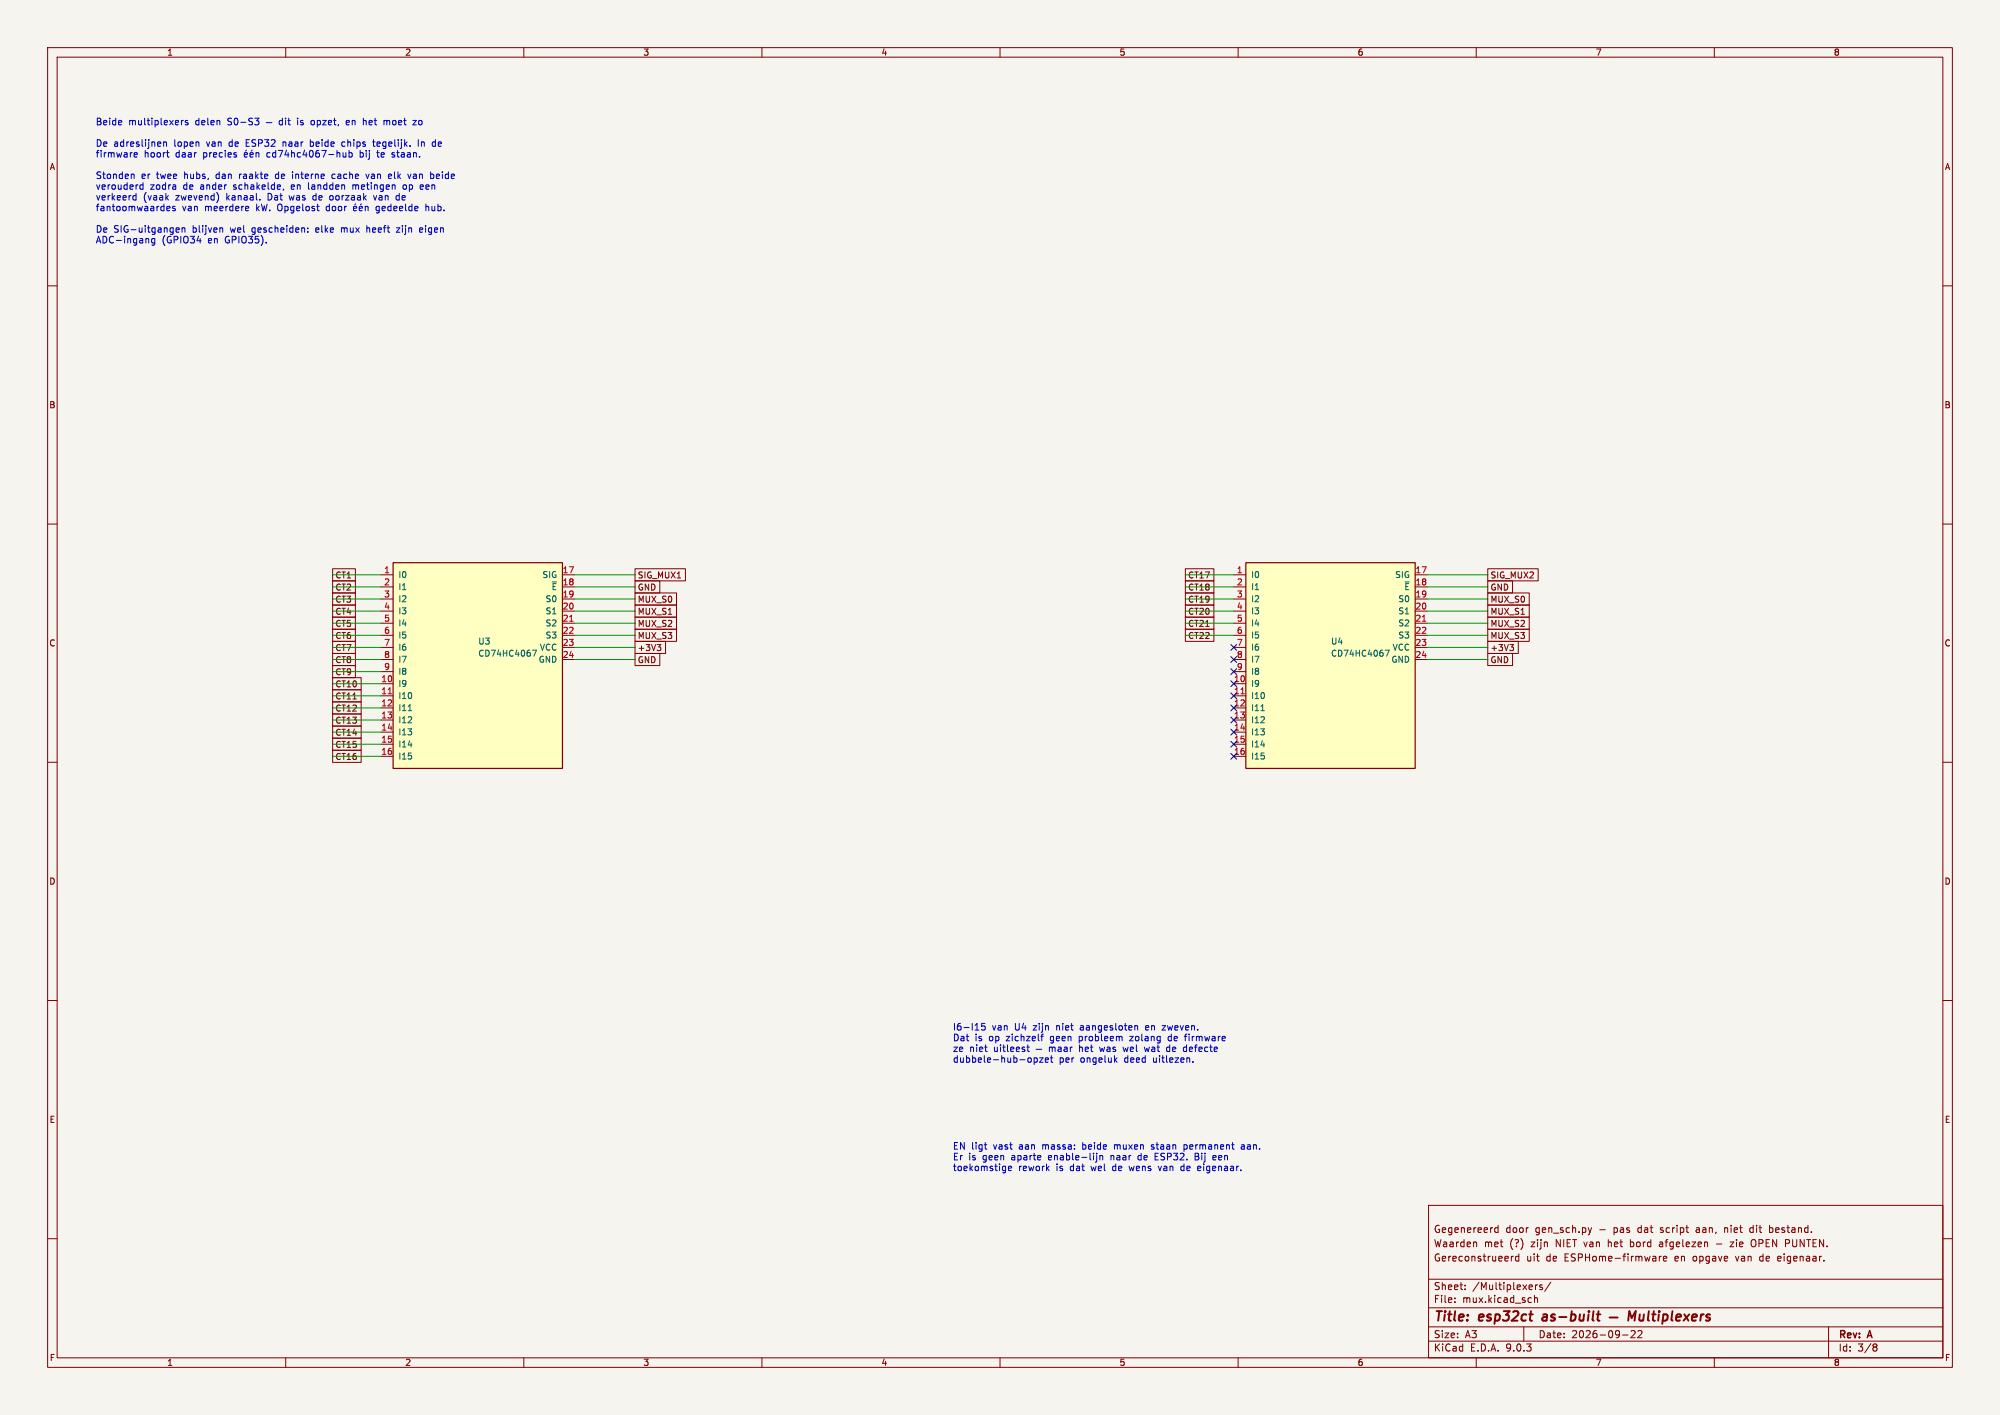
[picture p12: page 3]

verkeerd (vaak zwevend) kanaal. Dat was de oorzaak van de

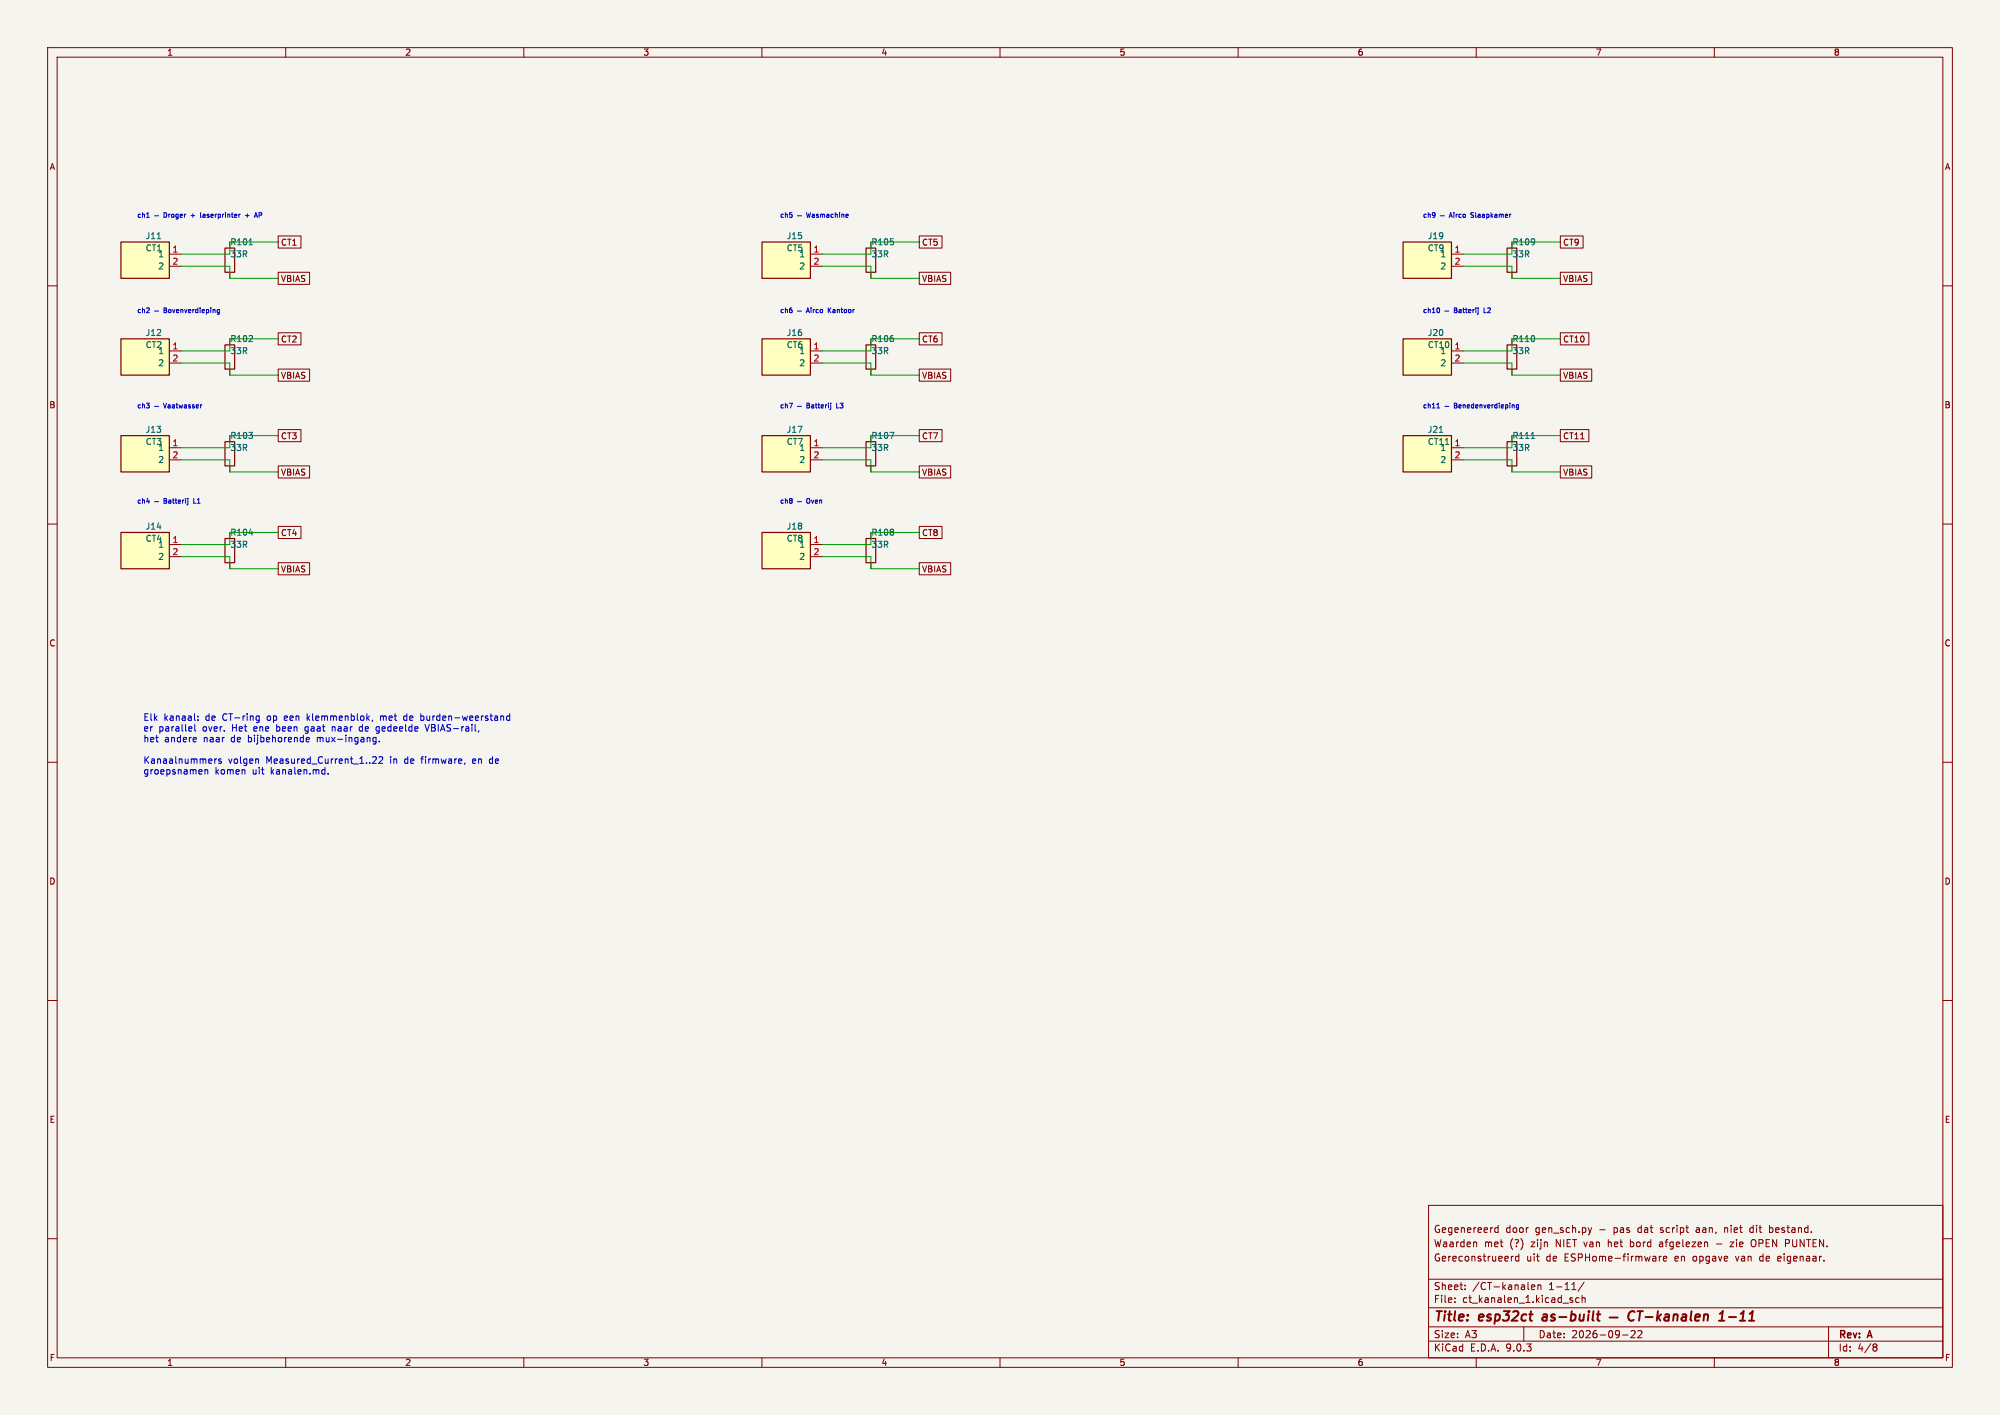
[picture p13: page 4]

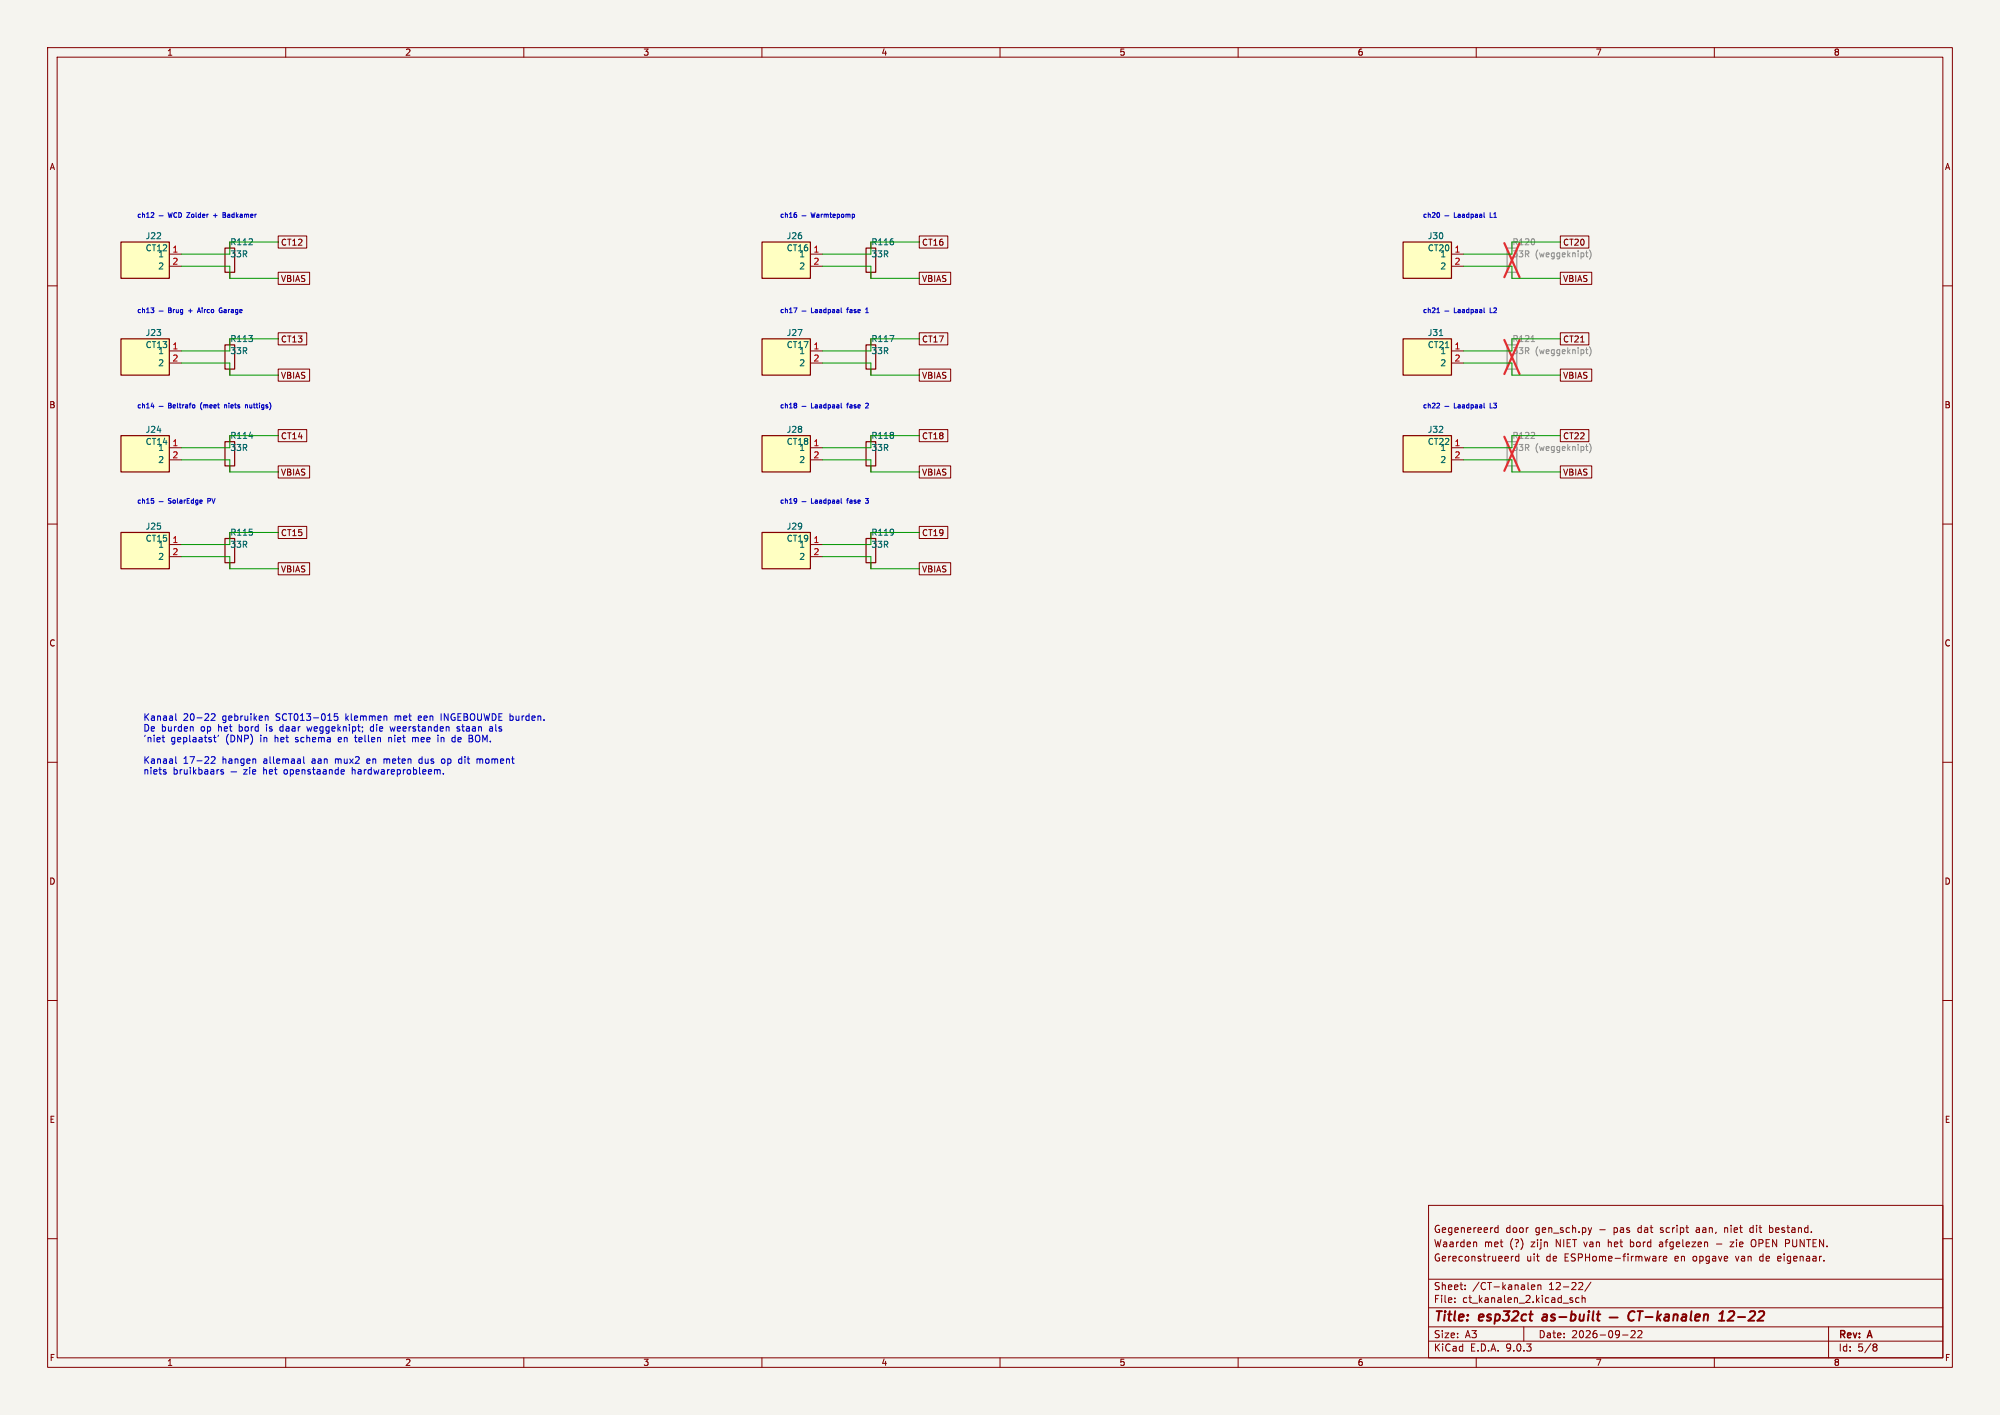
[picture p14: page 5]

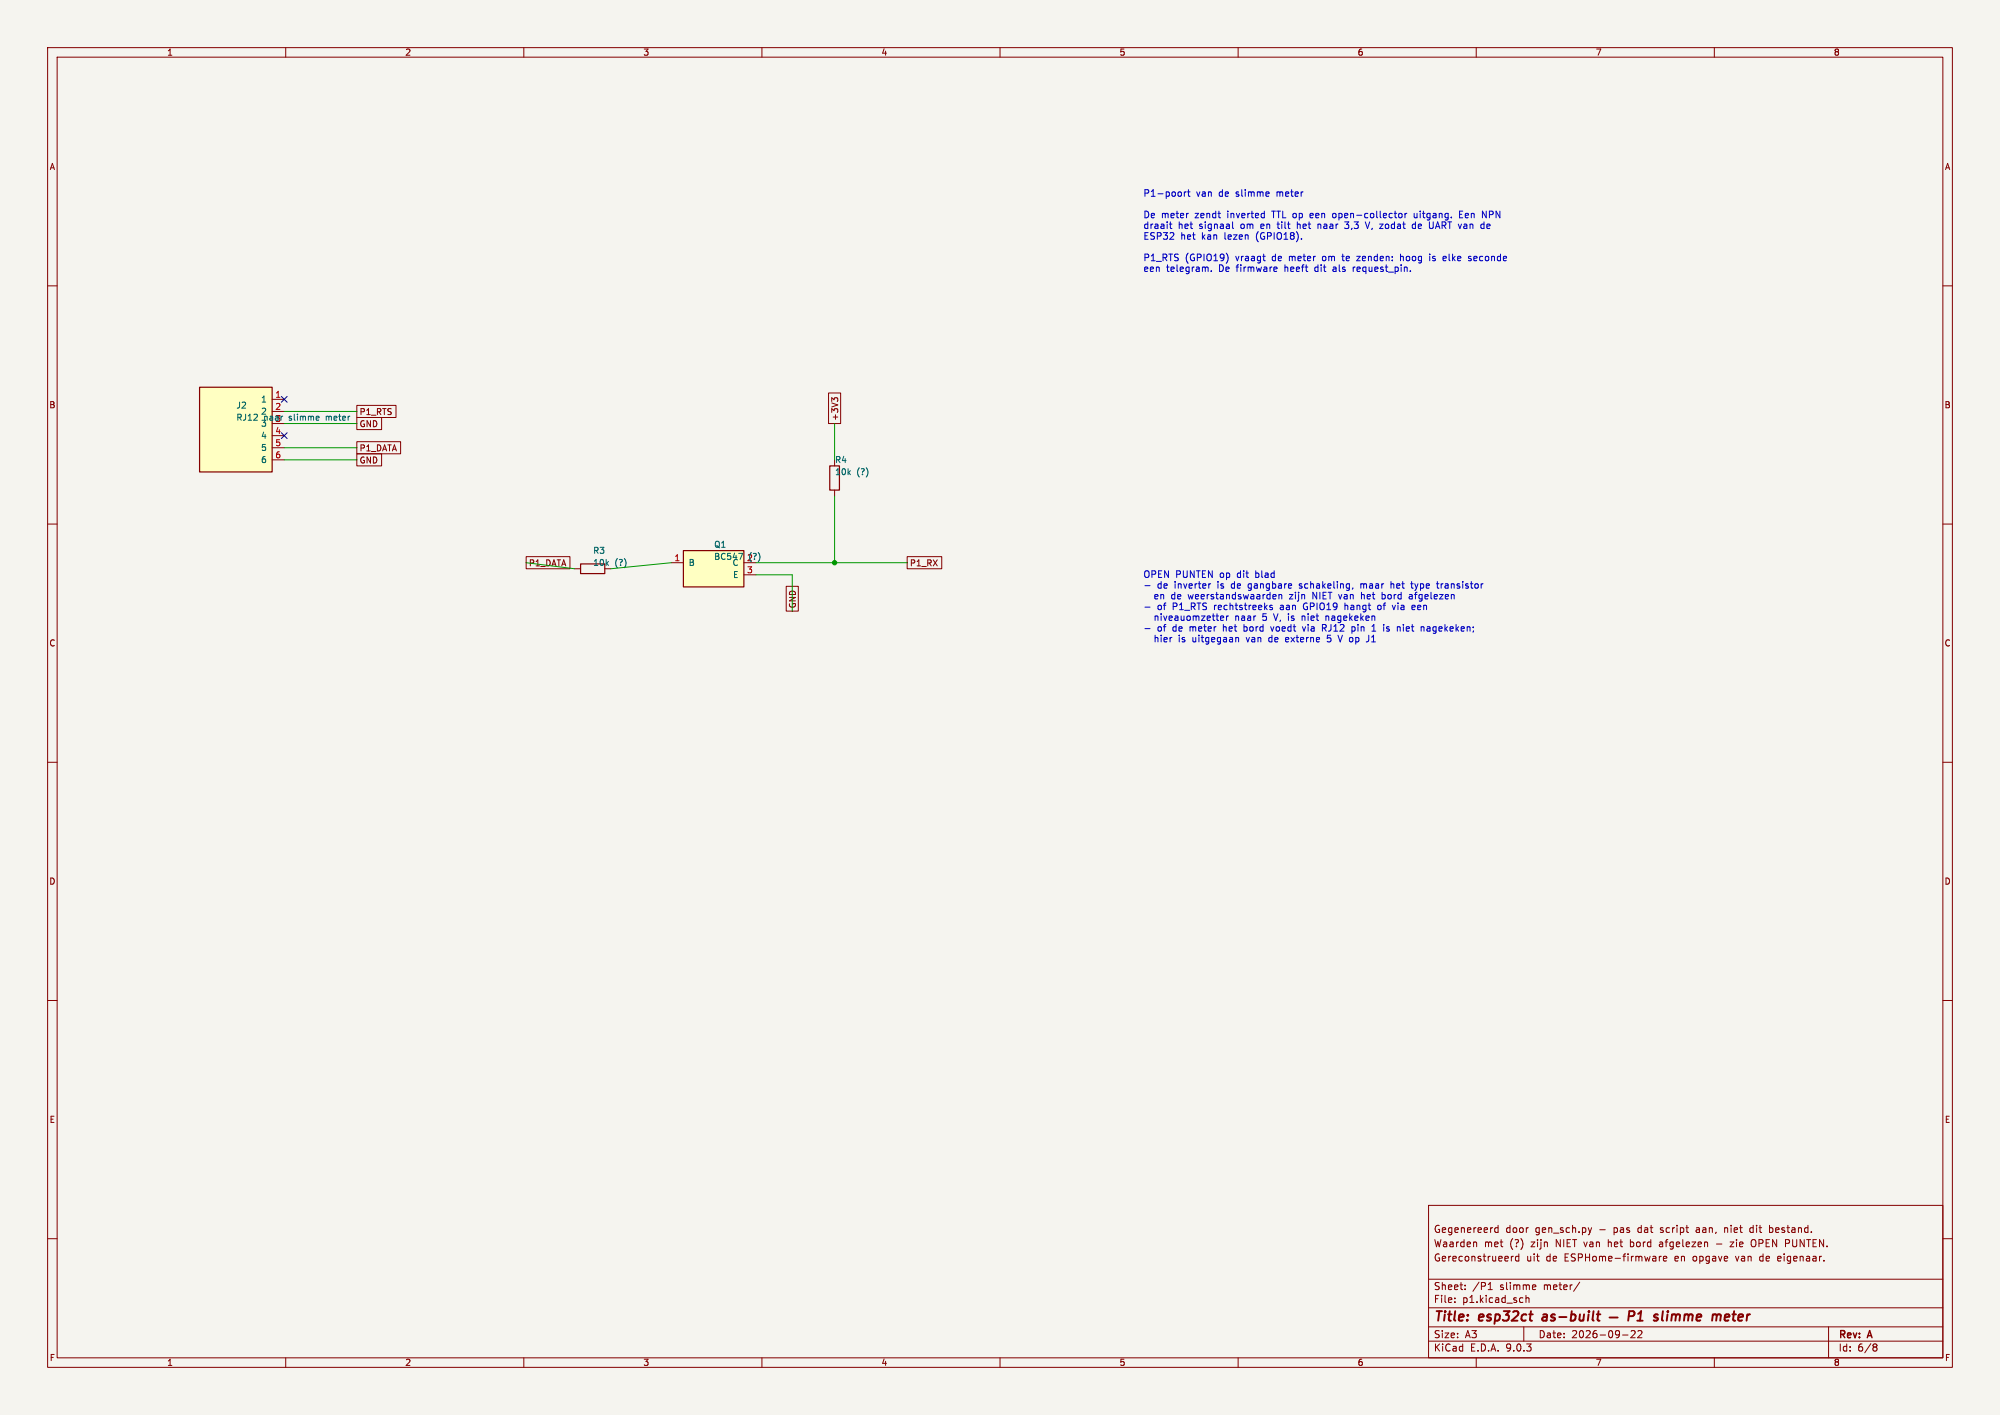
[picture p15: page 6]

draait het signaal om en tilt het naar 3,3 V, zodat de UART van de ESP32 het kan lezen (GPIO18).

P1_RTS (GPIO19) vraagt de meter om te zenden: hoog is elke seconde

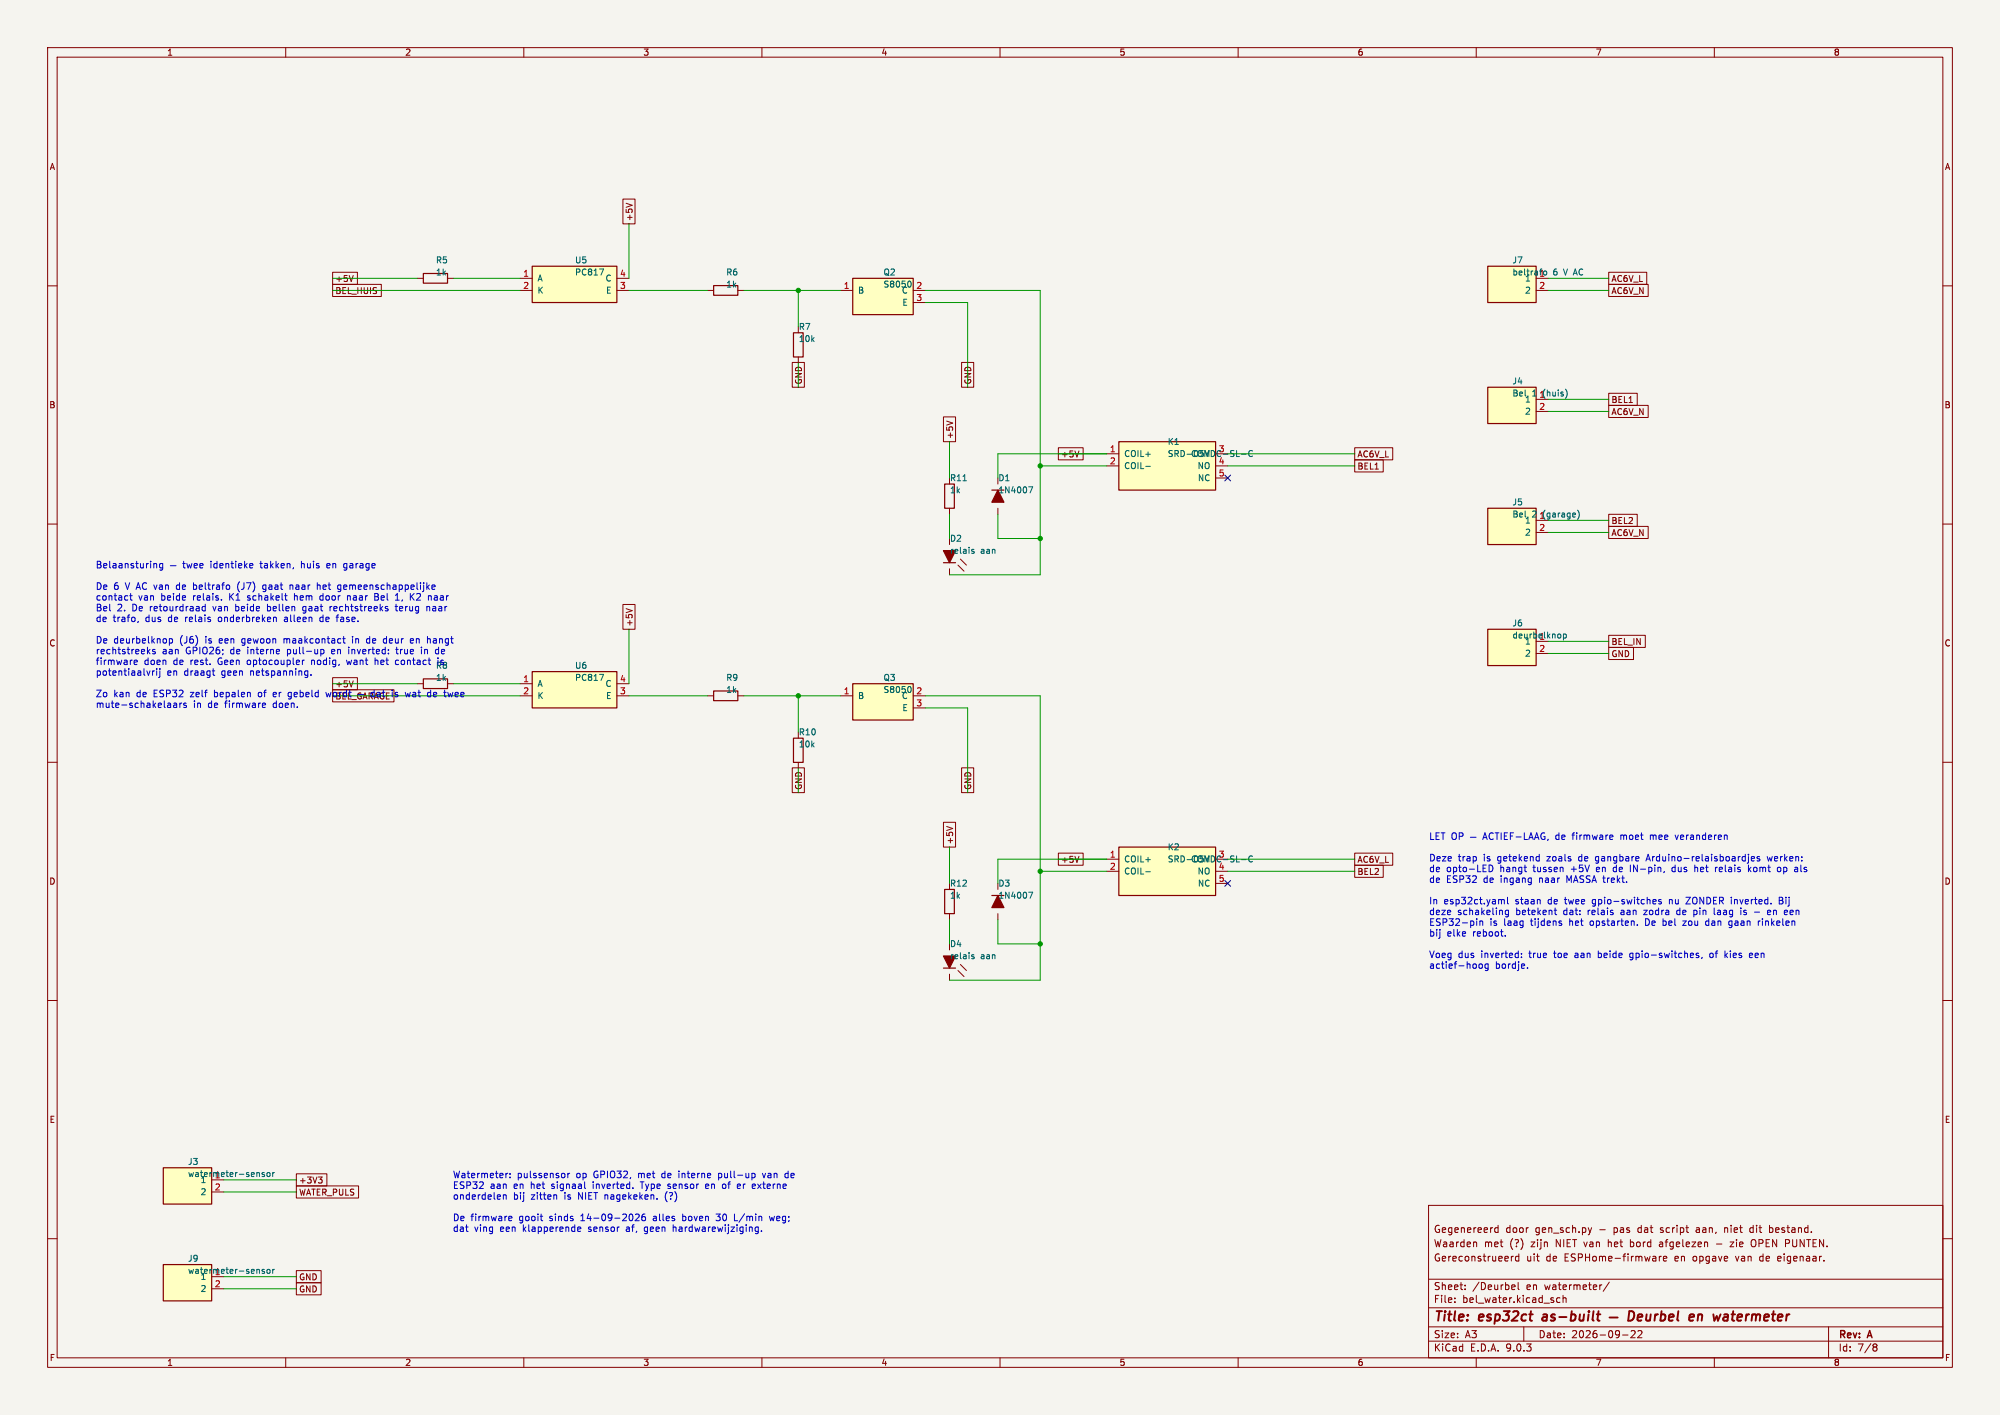
[picture p16: page 7]

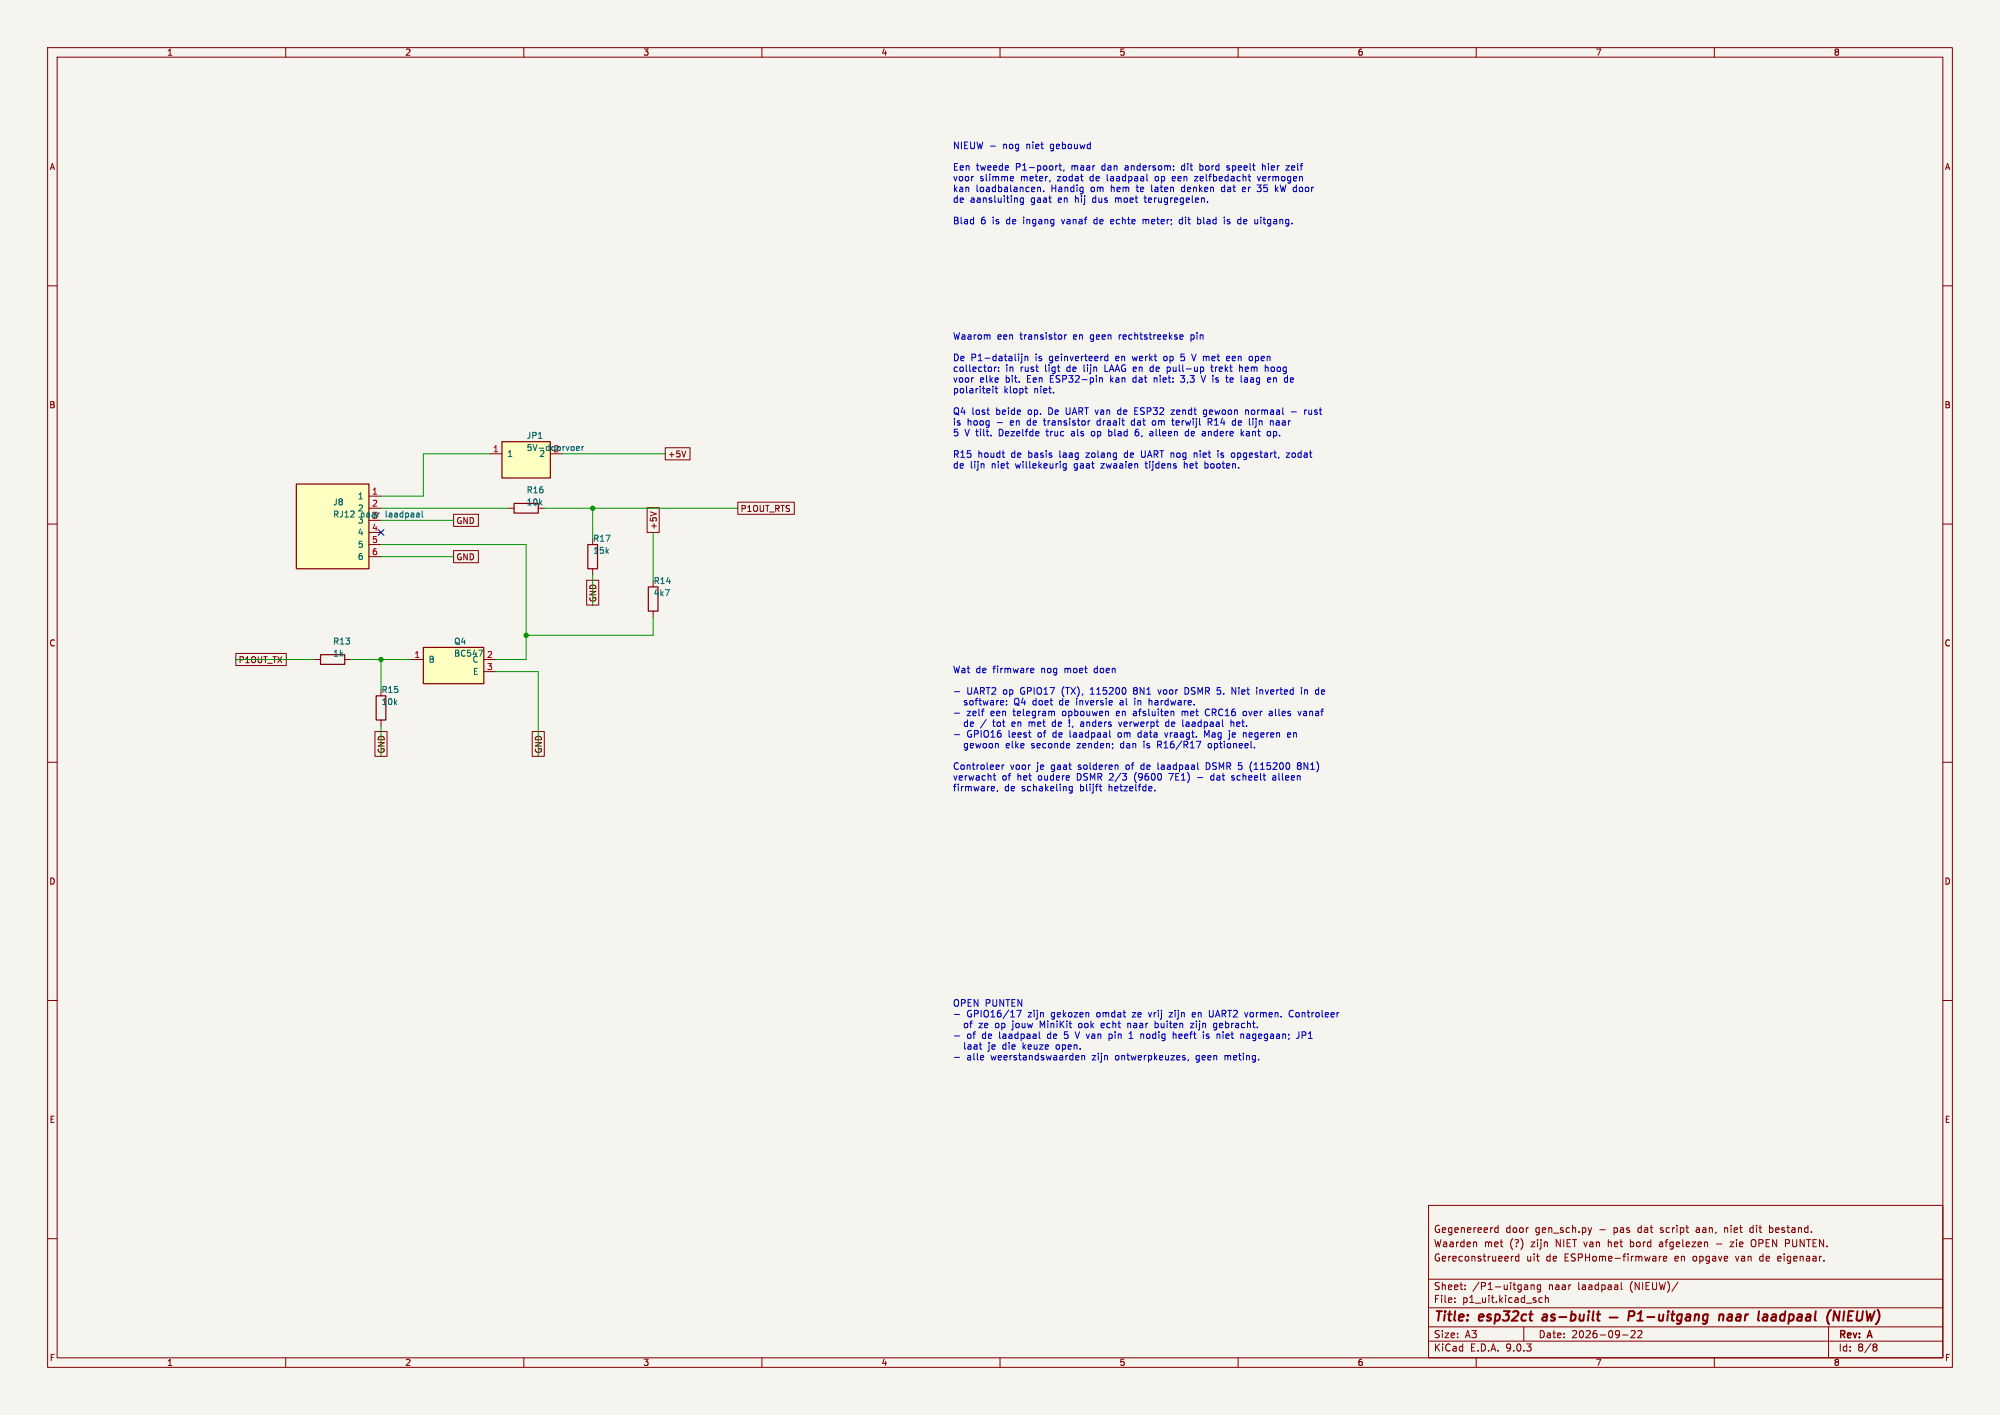
[picture p17: page 8]
