Aapjedotinfo/esp32ct/hardware/esp32ct-revc/bovenkant.pdf

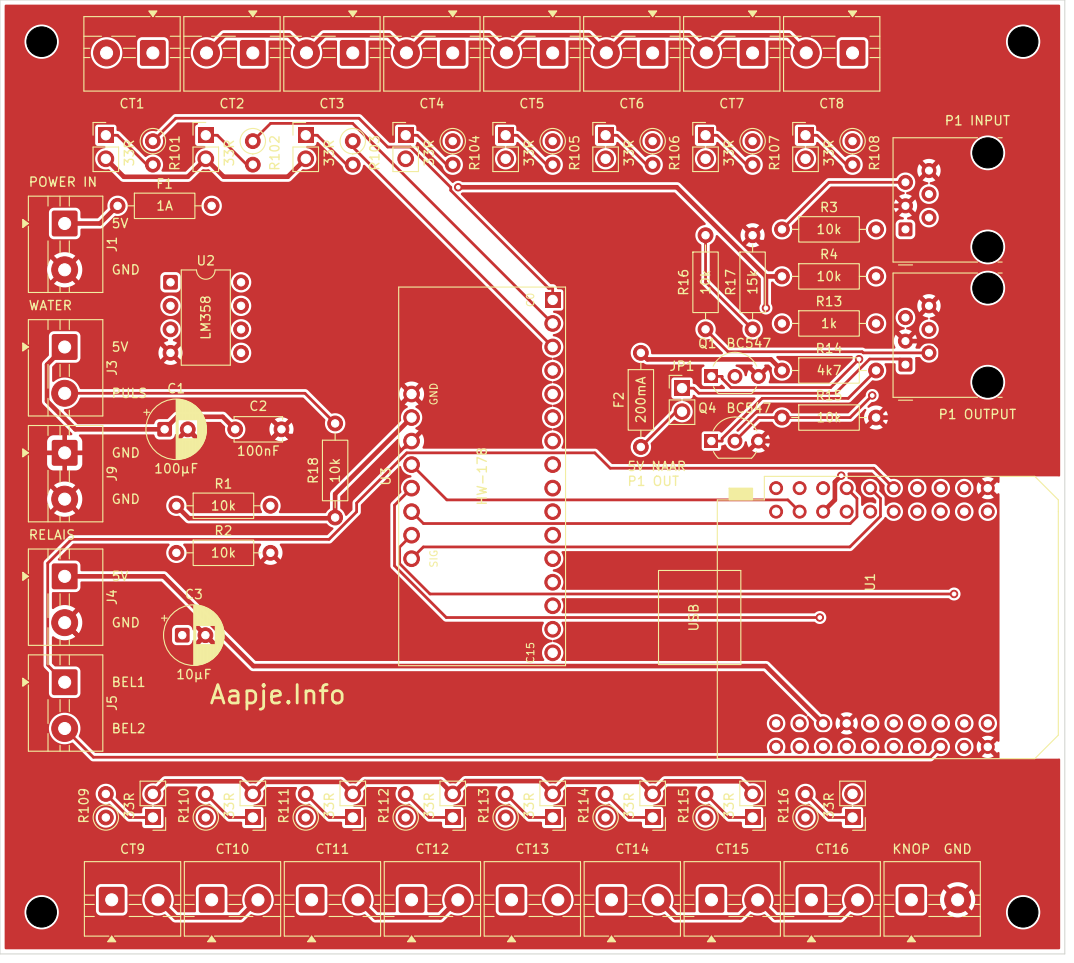
[picture p18: page 1]

P1 INPUT P1 OUTPUT Aapje.Info
