Aapjedotinfo/esp32ct/hardware/esp32ct-revc/onderkant.pdf

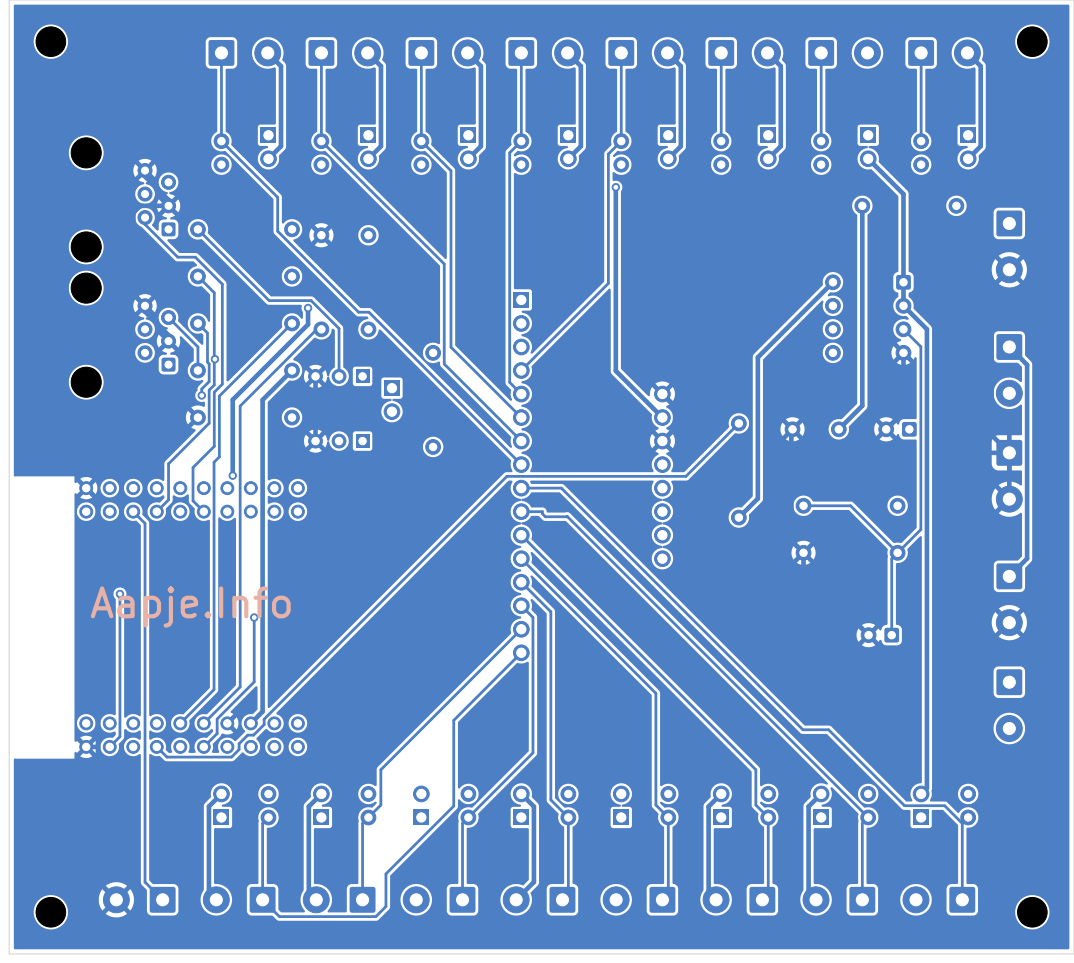
[picture p19: page 1]
