Aapjedotinfo/esp32ct/hardware/esp32ct-revc/plaatsing.pdf

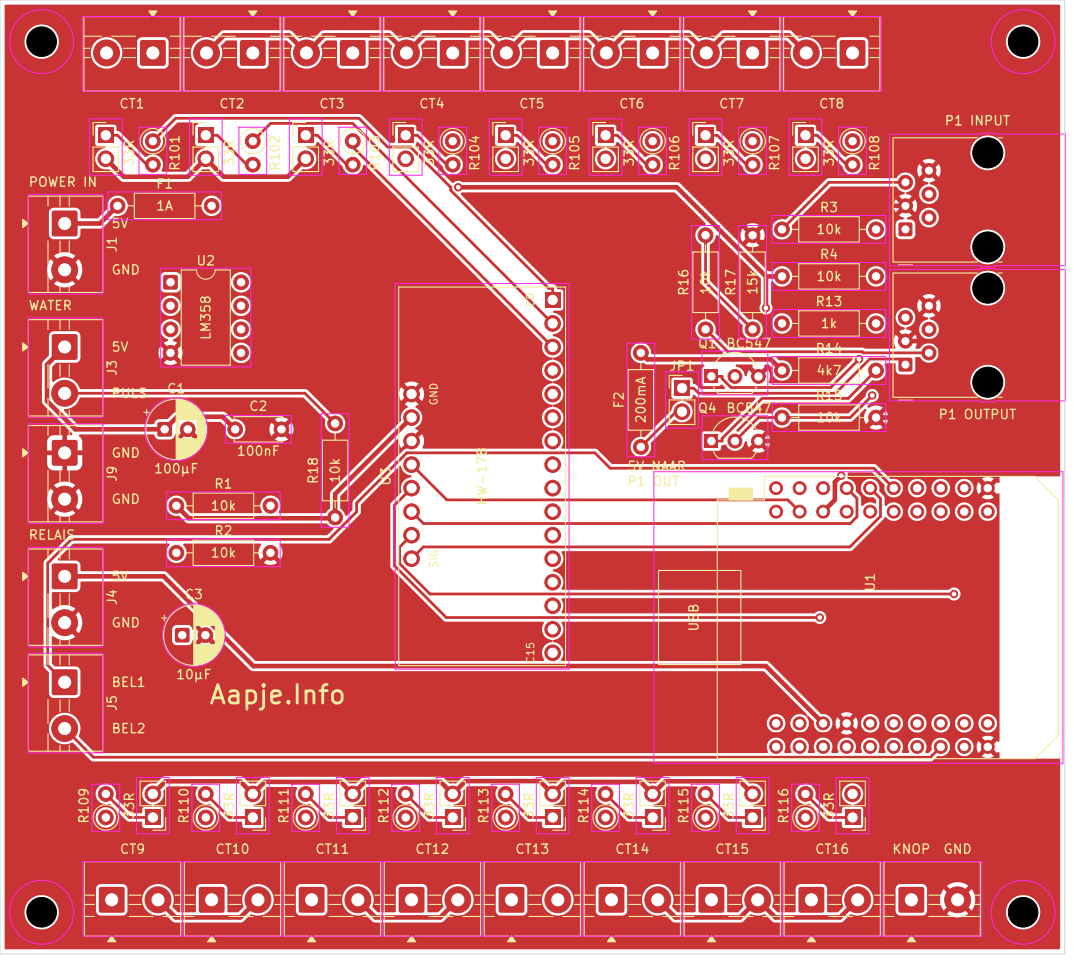
[picture p20: page 1]

P1 INPUT P1 OUTPUT Aapje.Info
