Aapjedotinfo/esp32ct/hardware/esp32ct-revc/esp32ct-revc.kicad_pcb

## KiCad design hardware/esp32ct-revc/esp32ct-revc.kicad_pcb (2026-10-31)

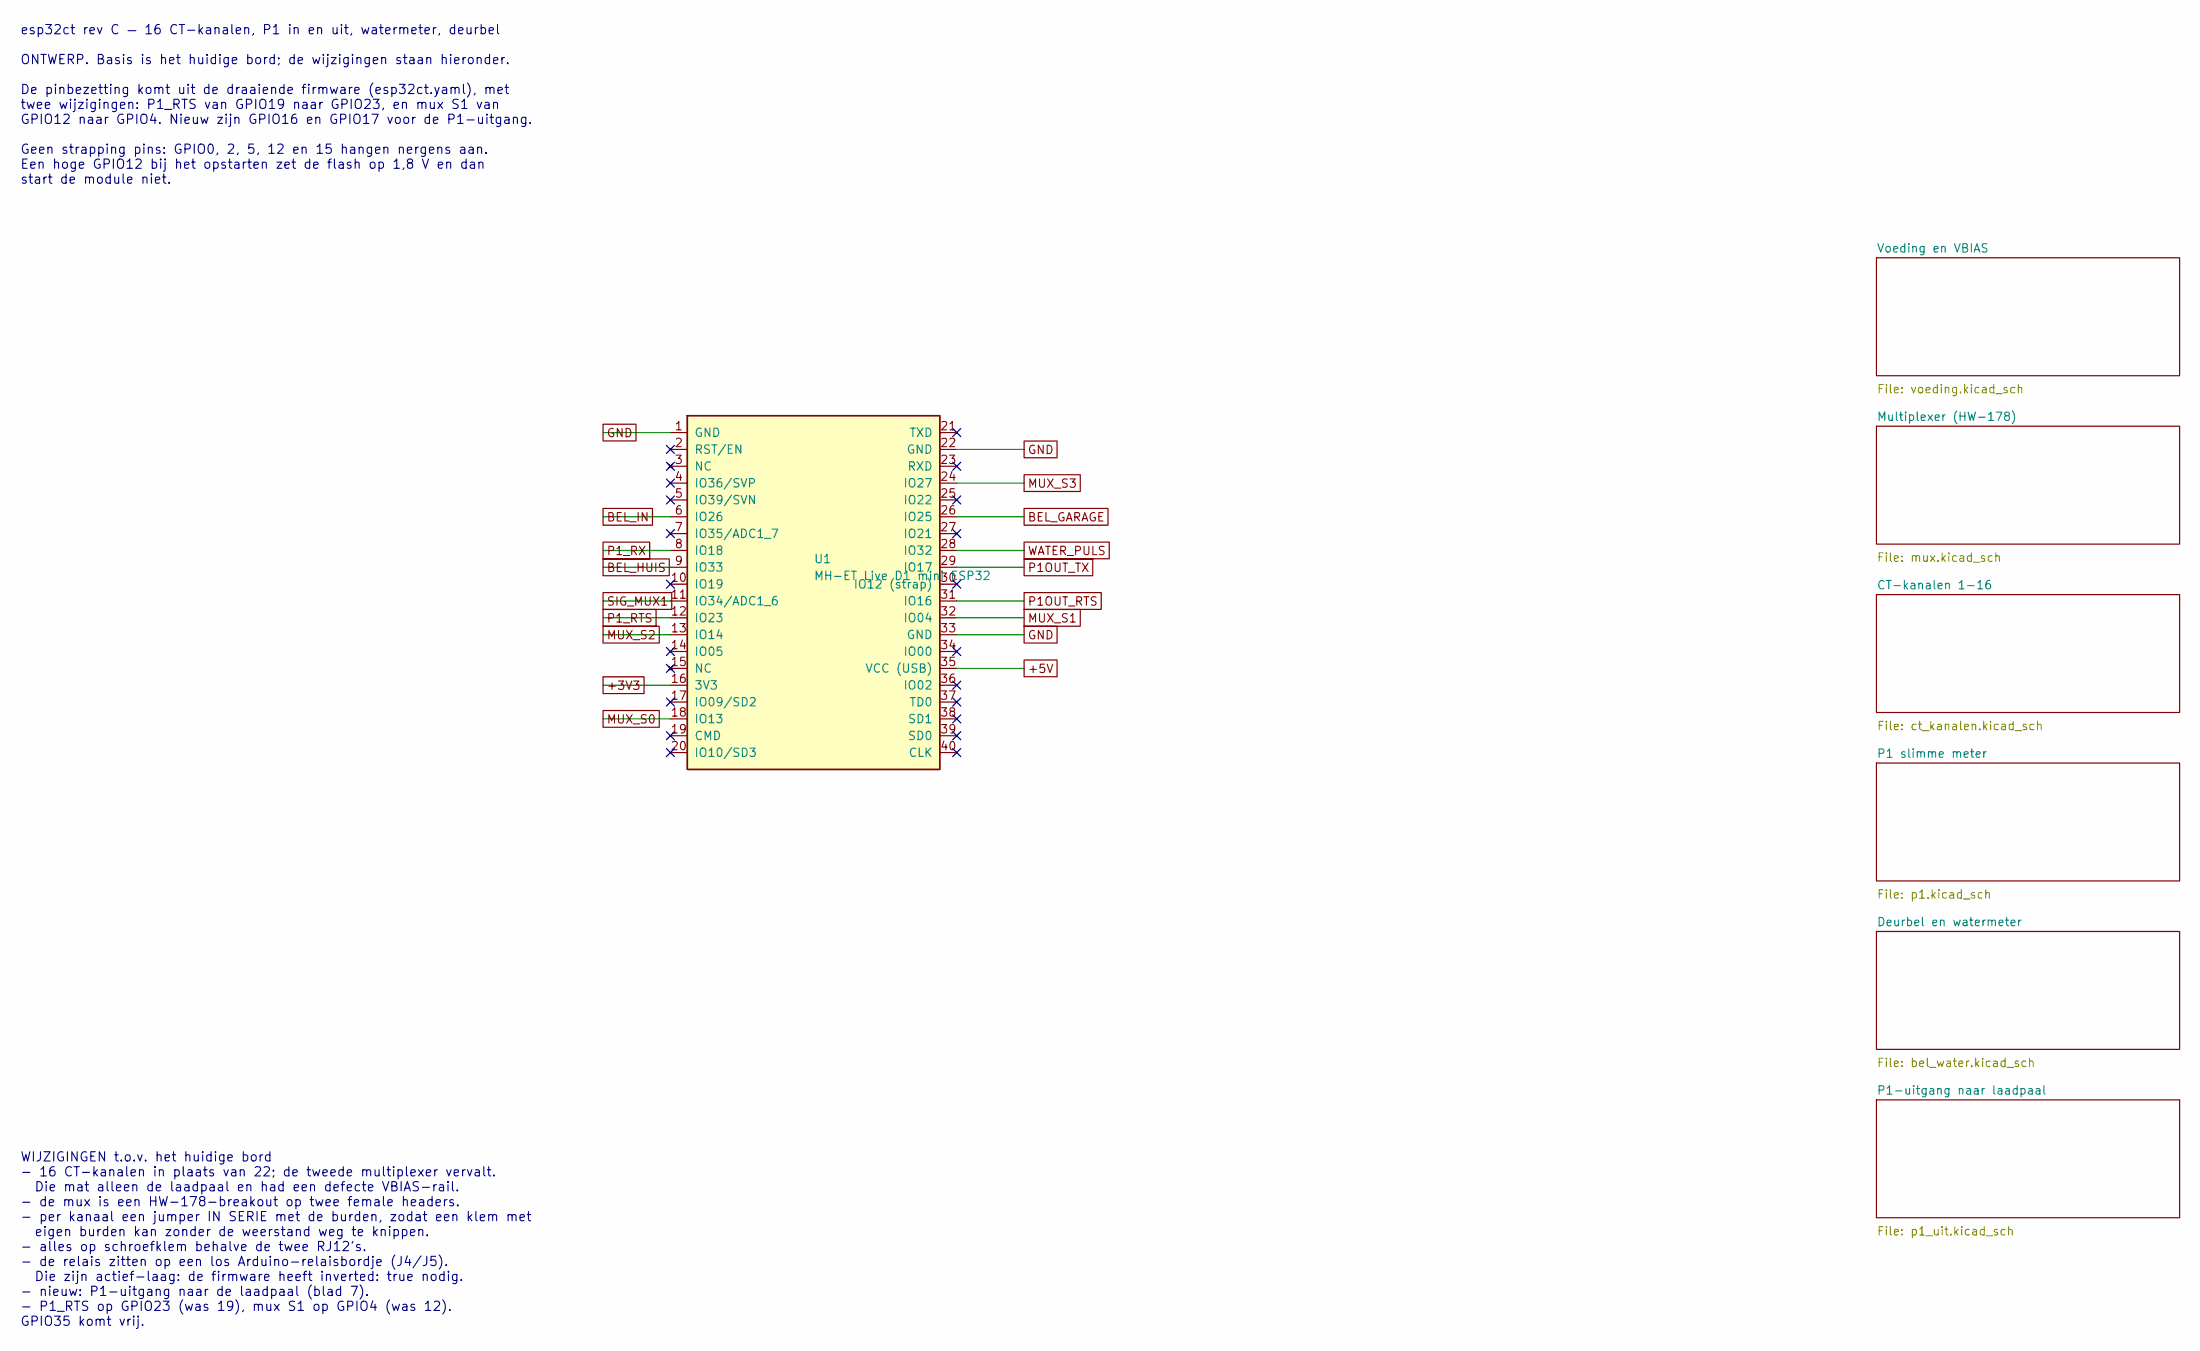
[picture p21: schematic esp32ct-revc.kicad_sch, esp32ct rev C — Overzicht en ESP32]

Parts:
U1: MH-ET Live D1 mini ESP32; ESP32_mini

Connections:
+3V3: U1.16 (3V3); also elsewhere on the board
+5V: U1.35 (VCC (USB)); also elsewhere on the board
BEL_GARAGE: U1.26 (IO25); also elsewhere on the board
BEL_HUIS: U1.9 (IO33); also elsewhere on the board
BEL_IN: U1.6 (IO26); also elsewhere on the board
GND: U1.1 (GND), U1.22 (GND), U1.33 (GND); also elsewhere on the board
MUX_S0: U1.18 (IO13); also elsewhere on the board
MUX_S1: U1.32 (IO04); also elsewhere on the board
MUX_S2: U1.13 (IO14); also elsewhere on the board
MUX_S3: U1.24 (IO27); also elsewhere on the board
P1OUT_RTS: U1.31 (IO16); also elsewhere on the board
P1OUT_TX: U1.29 (IO17); also elsewhere on the board
P1_RTS: U1.12 (IO23); also elsewhere on the board
P1_RX: U1.8 (IO18); also elsewhere on the board
SIG_MUX1: U1.11 (IO34/ADC1_6); also elsewhere on the board
WATER_PULS: U1.28 (IO32); also elsewhere on the board

Notes on the sheet:
esp32ct rev C — 16 CT-kanalen, P1 in en uit, watermeter, deurbel ONTWERP. Basis is het huidige bord; de wijzigingen staan hieronder. De pinbezetting komt uit de draaiende firmware (esp32ct.yaml), met twee wijzigingen: P1_RTS van GPIO19 naar GPIO23, en mux S1 van GPIO12 naar GPIO4. Nieuw zijn GPIO16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
WIJZIGINGEN t.o.v. het huidige bord - 16 CT-kanalen in plaats van 22; de tweede multiplexer vervalt. Die mat alleen de laadpaal en had een defecte VBIAS-rail. - de mux is een HW-178-breakout op twee female headers. - per kanaal een jumper IN SERIE met de burden, zodat een klem met eigen burden kan 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

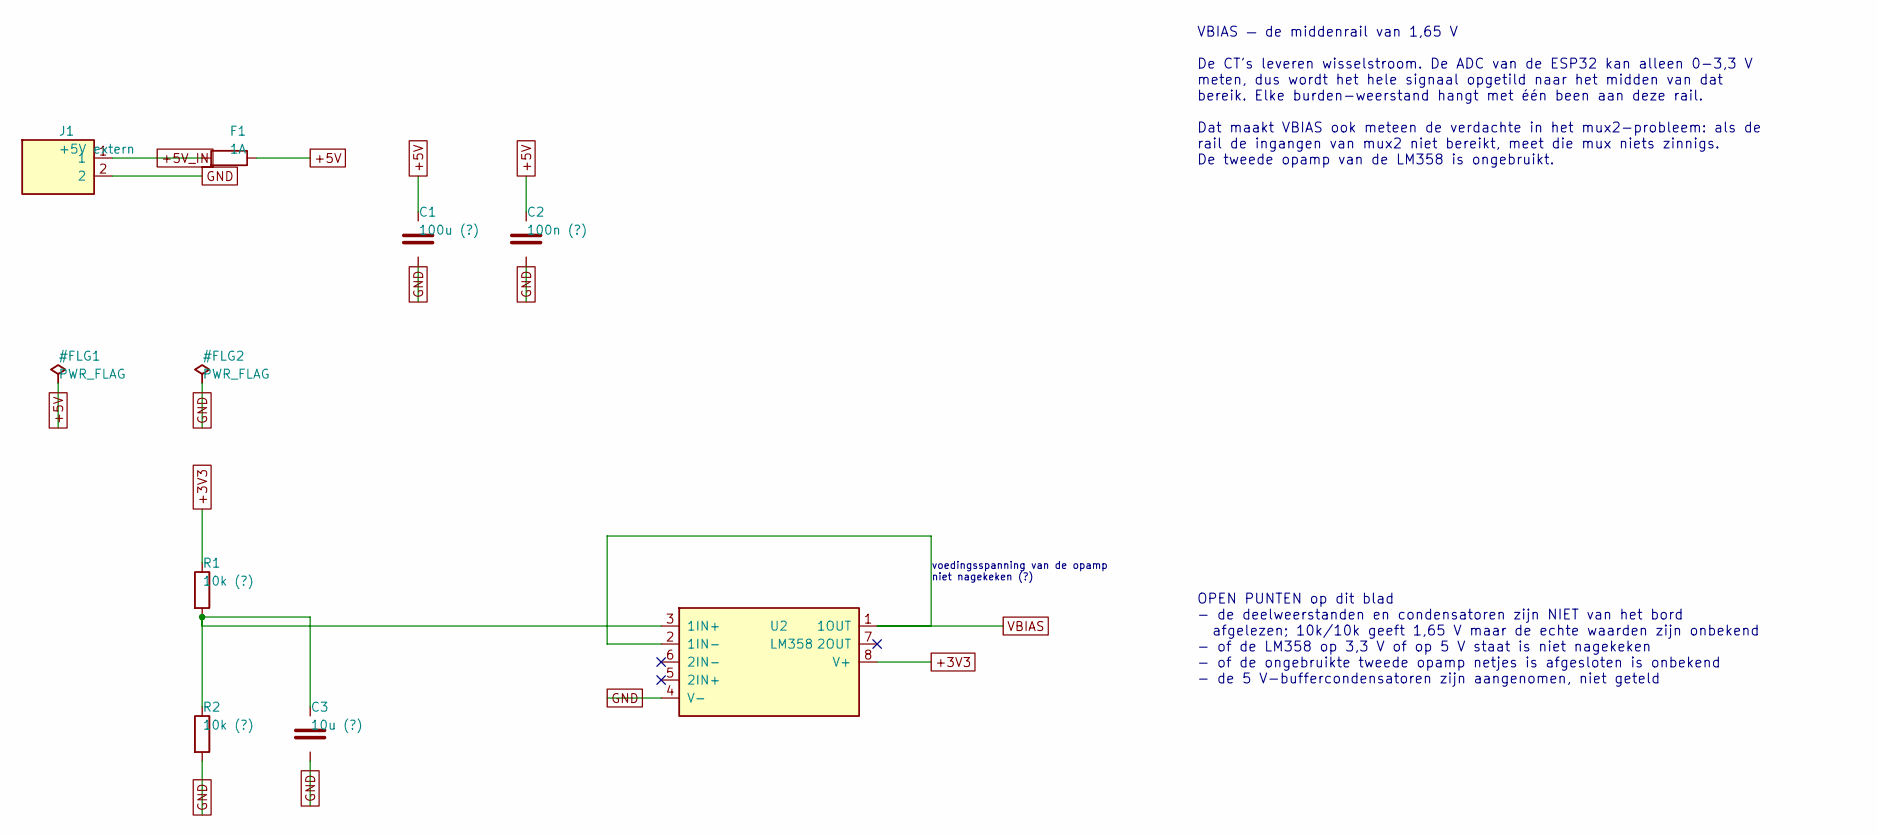
[picture p22: schematic voeding.kicad_sch, esp32ct rev C — Voeding en VBIAS]

Parts:
C1: 100u (?); CP_Radial_D6.3mm_P2.50mm
C2: 100n (?); C_Disc_D5.0mm_W2.5mm_P5.00mm
C3: 10u (?); CP_Radial_D6.3mm_P2.50mm
F1: 1A; R_Axial_DIN0207_L6.3mm_D2.5mm_P10.16mm_Horizontal
J1: +5V extern; MX126_2P_5mm_krap
R1, R2: 10k (?); R_Axial_DIN0207_L6.3mm_D2.5mm_P10.16mm_Horizontal
U2: LM358; DIP-8_W7.62mm

Connections:
+3V3: R1.1, U2.8 (V+); also elsewhere on the board
+5V: C1.1, C2.1, F1.2; also elsewhere on the board
+5V_IN: F1.1, J1.1
GND: C1.2, C2.2, C3.2, J1.2, R2.2, U2.4 (V-); also elsewhere on the board
unnamed: C3.1, R1.2, R2.1, U2.3 (1IN+)
VBIAS: U2.1 (1OUT), U2.2 (1IN-); also elsewhere on the board

Notes on the sheet:
voedingsspanning van de opamp niet nagekeken (?)
VBIAS — de middenrail van 1,65 V De CT's leveren wisselstroom. De ADC van de ESP32 kan alleen 0-3,3 V meten, dus wordt het hele signaal opgetild naar het midden van dat bereik. Elke burden-weerstand hangt met één been aan deze rail. Dat maakt VBIAS ook meteen de verdachte in het mux2-probleem: als 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
OPEN PUNTEN op dit blad - de deelweerstanden en condensatoren zijn NIET van het bord afgelezen; 10k/10k geeft 1,65 V maar de echte waarden zijn onbekend - of de LM358 op 3,3 V of op 5 V staat is niet nagekeken - of de ongebruikte tweede opamp netjes is afgesloten is onbekend - de 5 V-buffercondensa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

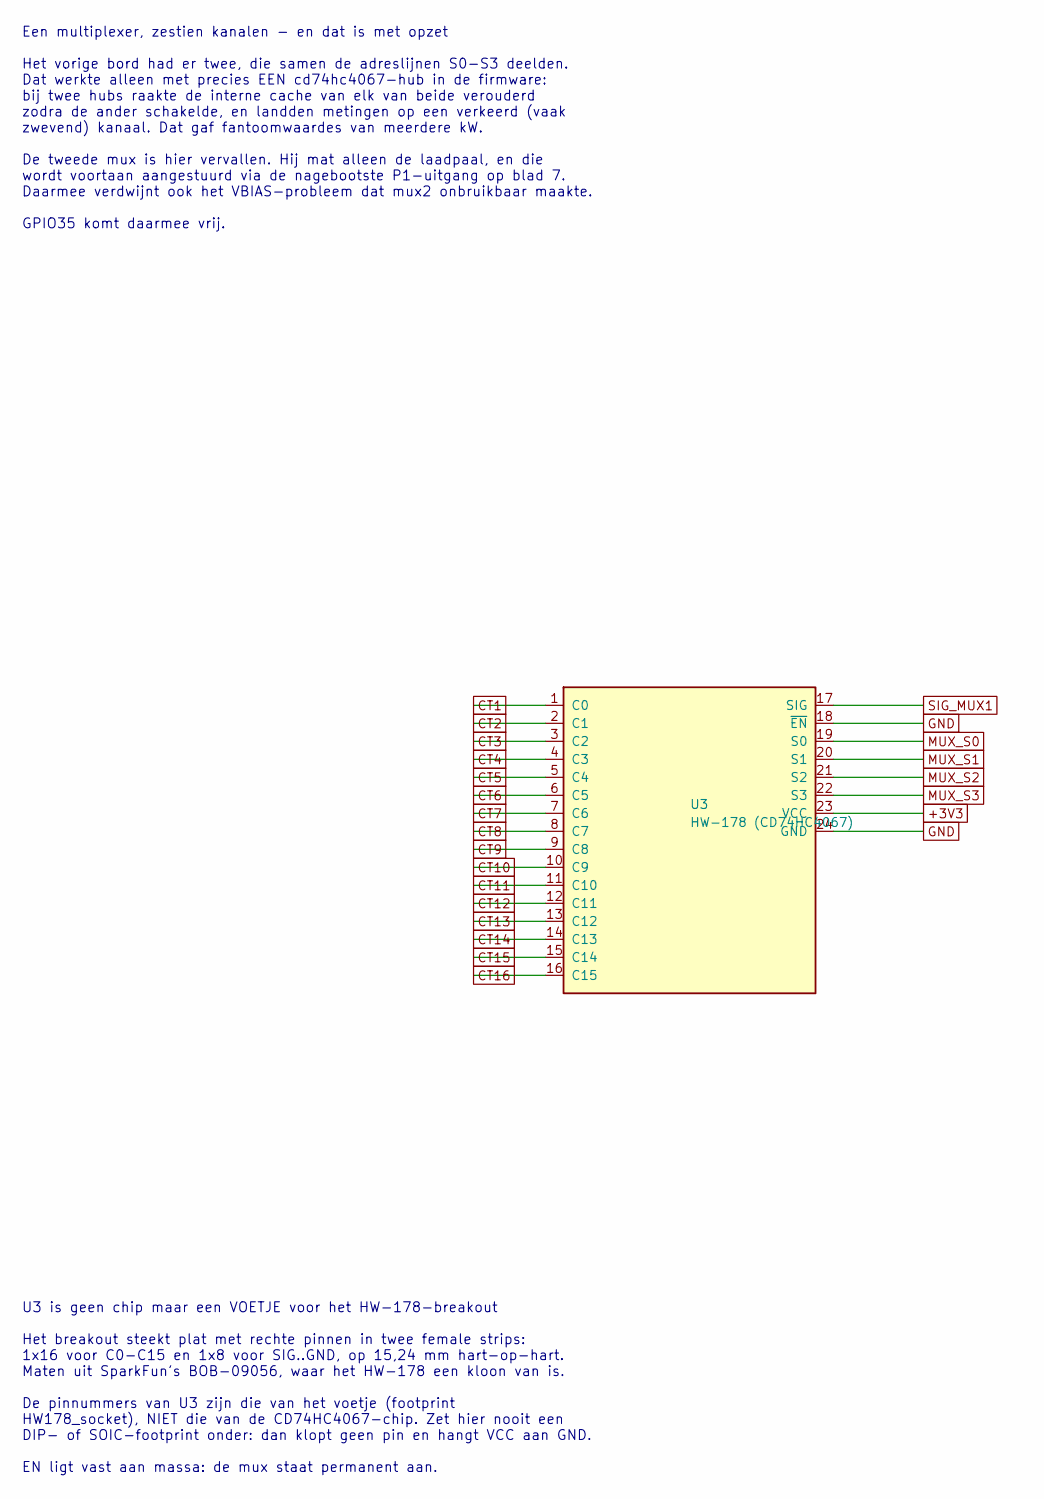
[picture p23: schematic mux.kicad_sch, esp32ct rev C — Multiplexer (HW-178)]

Parts:
U3: HW-178 (CD74HC4067); HW178_socket

Connections:
+3V3: U3.23 (VCC); also elsewhere on the board
CT1: U3.1 (C0); also elsewhere on the board
CT2: U3.2 (C1); also elsewhere on the board
CT3: U3.3 (C2); also elsewhere on the board
CT4: U3.4 (C3); also elsewhere on the board
CT5: U3.5 (C4); also elsewhere on the board
CT6: U3.6 (C5); also elsewhere on the board
CT7: U3.7 (C6); also elsewhere on the board
CT8: U3.8 (C7); also elsewhere on the board
CT9: U3.9 (C8); also elsewhere on the board
CT10: U3.10 (C9); also elsewhere on the board
CT11: U3.11 (C10); also elsewhere on the board
CT12: U3.12 (C11); also elsewhere on the board
CT13: U3.13 (C12); also elsewhere on the board
CT14: U3.14 (C13); also elsewhere on the board
CT15: U3.15 (C14); also elsewhere on the board
CT16: U3.16 (C15); also elsewhere on the board
GND: U3.18 (~EN), U3.24 (GND); also elsewhere on the board
MUX_S0: U3.19 (S0); also elsewhere on the board
MUX_S1: U3.20 (S1); also elsewhere on the board
MUX_S2: U3.21 (S2); also elsewhere on the board
MUX_S3: U3.22 (S3); also elsewhere on the board
SIG_MUX1: U3.17 (SIG); also elsewhere on the board

Notes on the sheet:
Een multiplexer, zestien kanalen - en dat is met opzet Het vorige bord had er twee, die samen de adreslijnen S0-S3 deelden. Dat werkte alleen met precies EEN cd74hc4067-hub in de firmware: bij twee hubs raakte de interne cache van elk van beide verouderd zodra de ander schakelde, en landden metinge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
U3 is geen chip maar een VOETJE voor het HW-178-breakout Het breakout steekt plat met rechte pinnen in twee female strips: 1x16 voor C0-C15 en 1x8 voor SIG..GND, op 15,24 mm hart-op-hart. Maten uit SparkFun's BOB-09056, waar het HW-178 een kloon van is. De pinnummers van U3 zijn die van het voetje 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

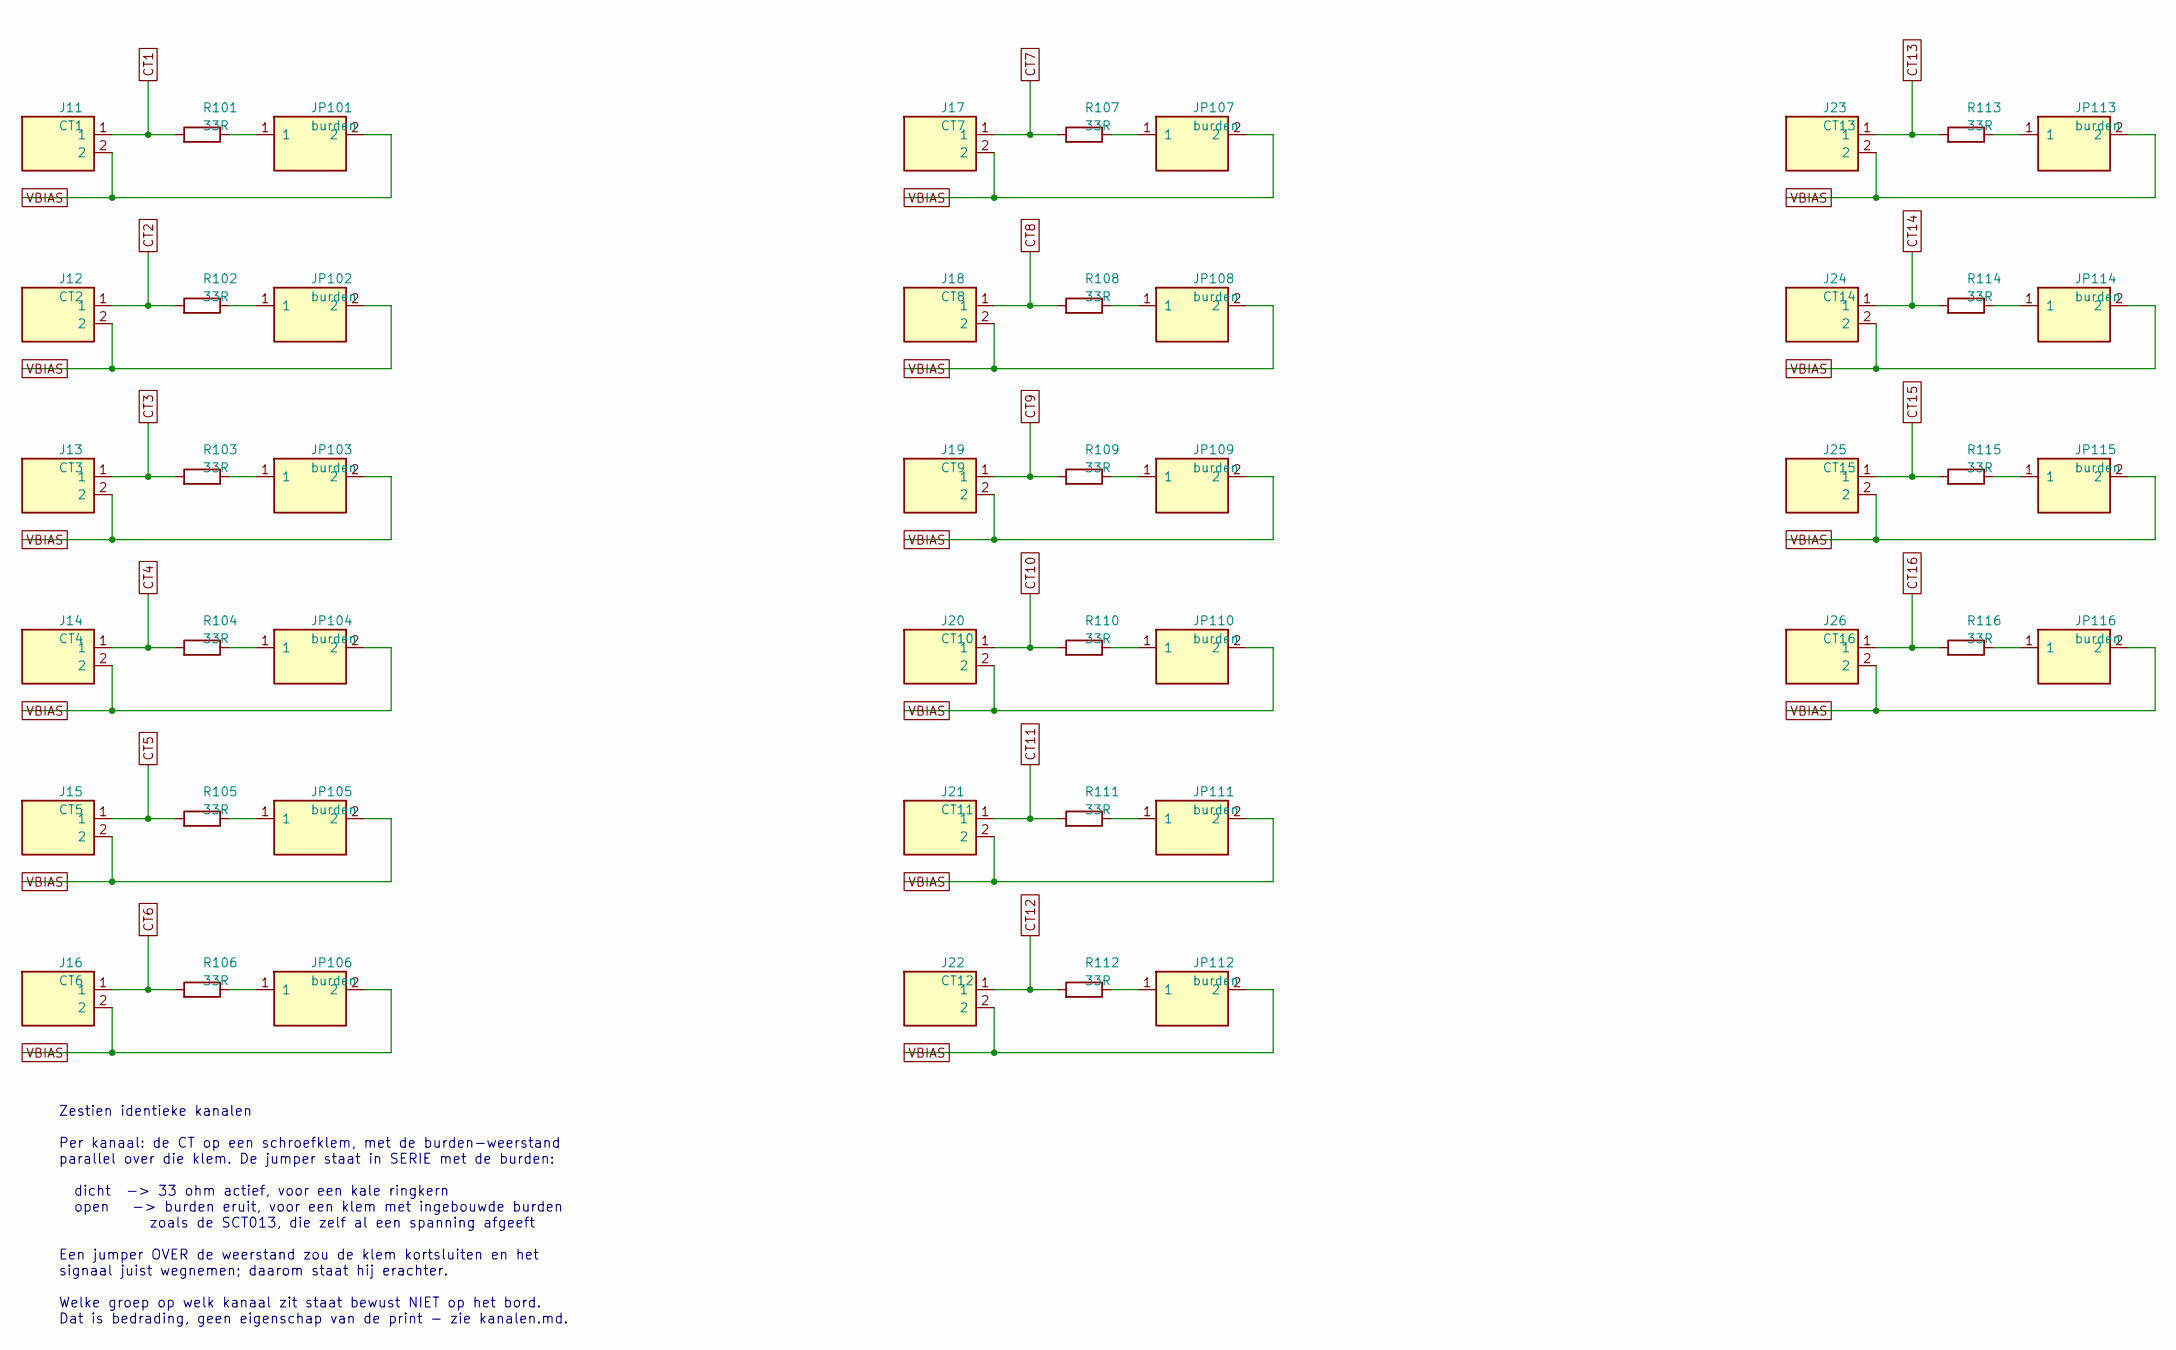
[picture p24: schematic ct_kanalen.kicad_sch, esp32ct rev C — CT-kanalen 1-16]

Parts:
J11: CT1; MX126_2P_5mm_krap
J12: CT2; MX126_2P_5mm_krap
J13: CT3; MX126_2P_5mm_krap
J14: CT4; MX126_2P_5mm_krap
J15: CT5; MX126_2P_5mm_krap
J16: CT6; MX126_2P_5mm_krap
J17: CT7; MX126_2P_5mm_krap
J18: CT8; MX126_2P_5mm_krap
J19: CT9; MX126_2P_5mm_krap
J20: CT10; MX126_2P_5mm_krap
J21: CT11; MX126_2P_5mm_krap
J22: CT12; MX126_2P_5mm_krap
J23: CT13; MX126_2P_5mm_krap
J24: CT14; MX126_2P_5mm_krap
J25: CT15; MX126_2P_5mm_krap
J26: CT16; MX126_2P_5mm_krap
JP101, JP102, JP103, JP104, JP105, JP106, JP107, JP108, JP109, JP110, JP111, JP112, JP113, JP114, JP115, JP116: burden; PinHeader_1x02_P2.54mm_Vertical
R101, R102, R103, R104, R105, R106, R107, R108, R109, R110, R111, R112, R113, R114, R115, R116: 33R; R_Axial_DIN0207_L6.3mm_D2.5mm_P2.54mm_Vertical

Connections:
CT1: J11.1, R101.1; also elsewhere on the board
CT2: J12.1, R102.1; also elsewhere on the board
CT3: J13.1, R103.1; also elsewhere on the board
CT4: J14.1, R104.1; also elsewhere on the board
CT5: J15.1, R105.1; also elsewhere on the board
CT6: J16.1, R106.1; also elsewhere on the board
CT7: J17.1, R107.1; also elsewhere on the board
CT8: J18.1, R108.1; also elsewhere on the board
CT9: J19.1, R109.1; also elsewhere on the board
CT10: J20.1, R110.1; also elsewhere on the board
CT11: J21.1, R111.1; also elsewhere on the board
CT12: J22.1, R112.1; also elsewhere on the board
CT13: J23.1, R113.1; also elsewhere on the board
CT14: J24.1, R114.1; also elsewhere on the board
CT15: J25.1, R115.1; also elsewhere on the board
CT16: J26.1, R116.1; also elsewhere on the board
unnamed: JP101.1, R101.2
unnamed: JP102.1, R102.2
unnamed: JP103.1, R103.2
unnamed: JP104.1, R104.2
unnamed: JP105.1, R105.2
unnamed: JP106.1, R106.2
unnamed: JP107.1, R107.2
unnamed: JP108.1, R108.2
unnamed: JP109.1, R109.2
unnamed: JP110.1, R110.2
unnamed: JP111.1, R111.2
unnamed: JP112.1, R112.2
unnamed: JP113.1, R113.2
unnamed: JP114.1, R114.2
unnamed: JP115.1, R115.2
unnamed: JP116.1, R116.2
VBIAS: J11.2, J12.2, J13.2, J14.2, J15.2, J16.2, J17.2, J18.2, J19.2, J20.2, J21.2, J22.2, J23.2, J24.2, J25.2, J26.2, JP101.2, JP102.2, JP103.2, JP104.2, JP105.2, JP106.2, JP107.2, JP108.2, JP109.2, JP110.2, JP111.2, JP112.2, JP113.2, JP114.2, JP115.2, JP116.2; also elsewhere on the board

Notes on the sheet:
Zestien identieke kanalen Per kanaal: de CT op een schroefklem, met de burden-weerstand parallel over die klem. De jumper staat in SERIE met de burden: dicht -> 33 ohm actief, voor een kale ringkern open -> burden eruit, voor een klem met ingebouwde burden zoals de SCT013, die zelf al een spanning 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

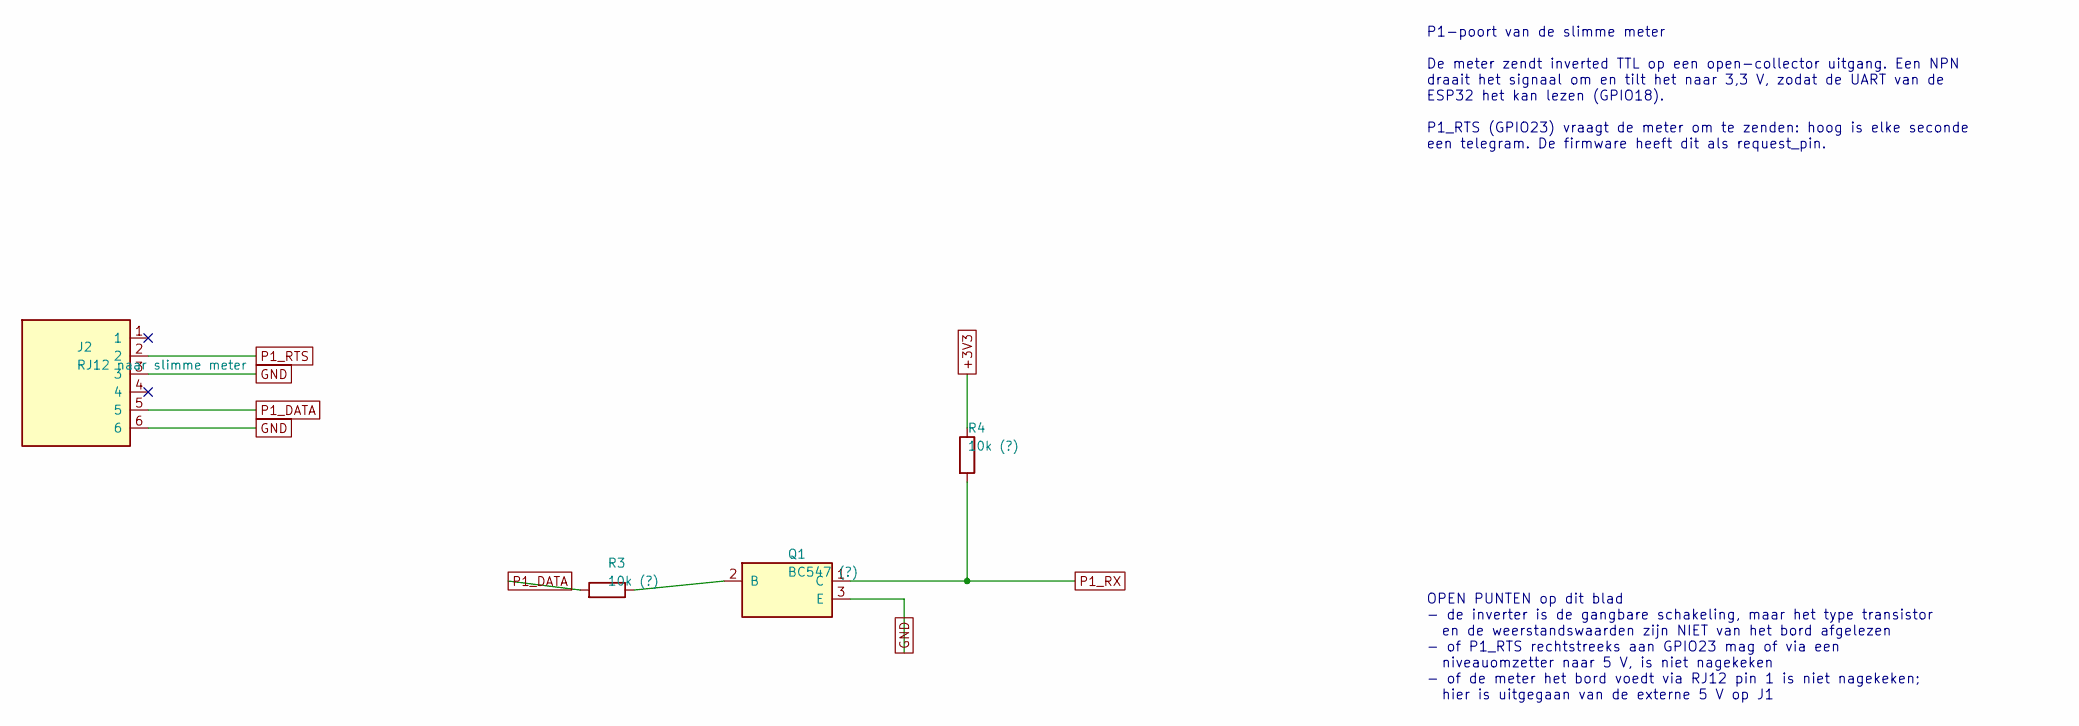
[picture p25: schematic p1.kicad_sch, esp32ct rev C — P1 slimme meter]

Parts:
J2: RJ12 naar slimme meter; RJ12_Amphenol_54601-x06_Horizontal
Q1: BC547 (?); TO-92_Inline_Wide
R3, R4: 10k (?); R_Axial_DIN0207_L6.3mm_D2.5mm_P10.16mm_Horizontal

Connections:
+3V3: R4.1; also elsewhere on the board
GND: J2.3, J2.6, Q1.3 (E); also elsewhere on the board
unnamed: Q1.2 (B), R3.2
P1_DATA: J2.5, R3.1
P1_RTS: J2.2; also elsewhere on the board
P1_RX: Q1.1 (C), R4.2; also elsewhere on the board

Notes on the sheet:
P1-poort van de slimme meter De meter zendt inverted TTL op een open-collector uitgang. Een NPN draait het signaal om en tilt het naar 3,3 V, zodat de UART van de ESP32 het kan lezen (GPIO18). P1_RTS (GPIO23) vraagt de meter om te zenden: hoog is elke seconde een telegram. De firmware heeft dit als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
OPEN PUNTEN op dit blad - de inverter is de gangbare schakeling, maar het type transistor en de weerstandswaarden zijn NIET van het bord afgelezen - of P1_RTS rechtstreeks aan GPIO23 mag of via een niveauomzetter naar 5 V, is niet nagekeken - of de meter het bord voedt via RJ12 pin 1 is niet nageke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

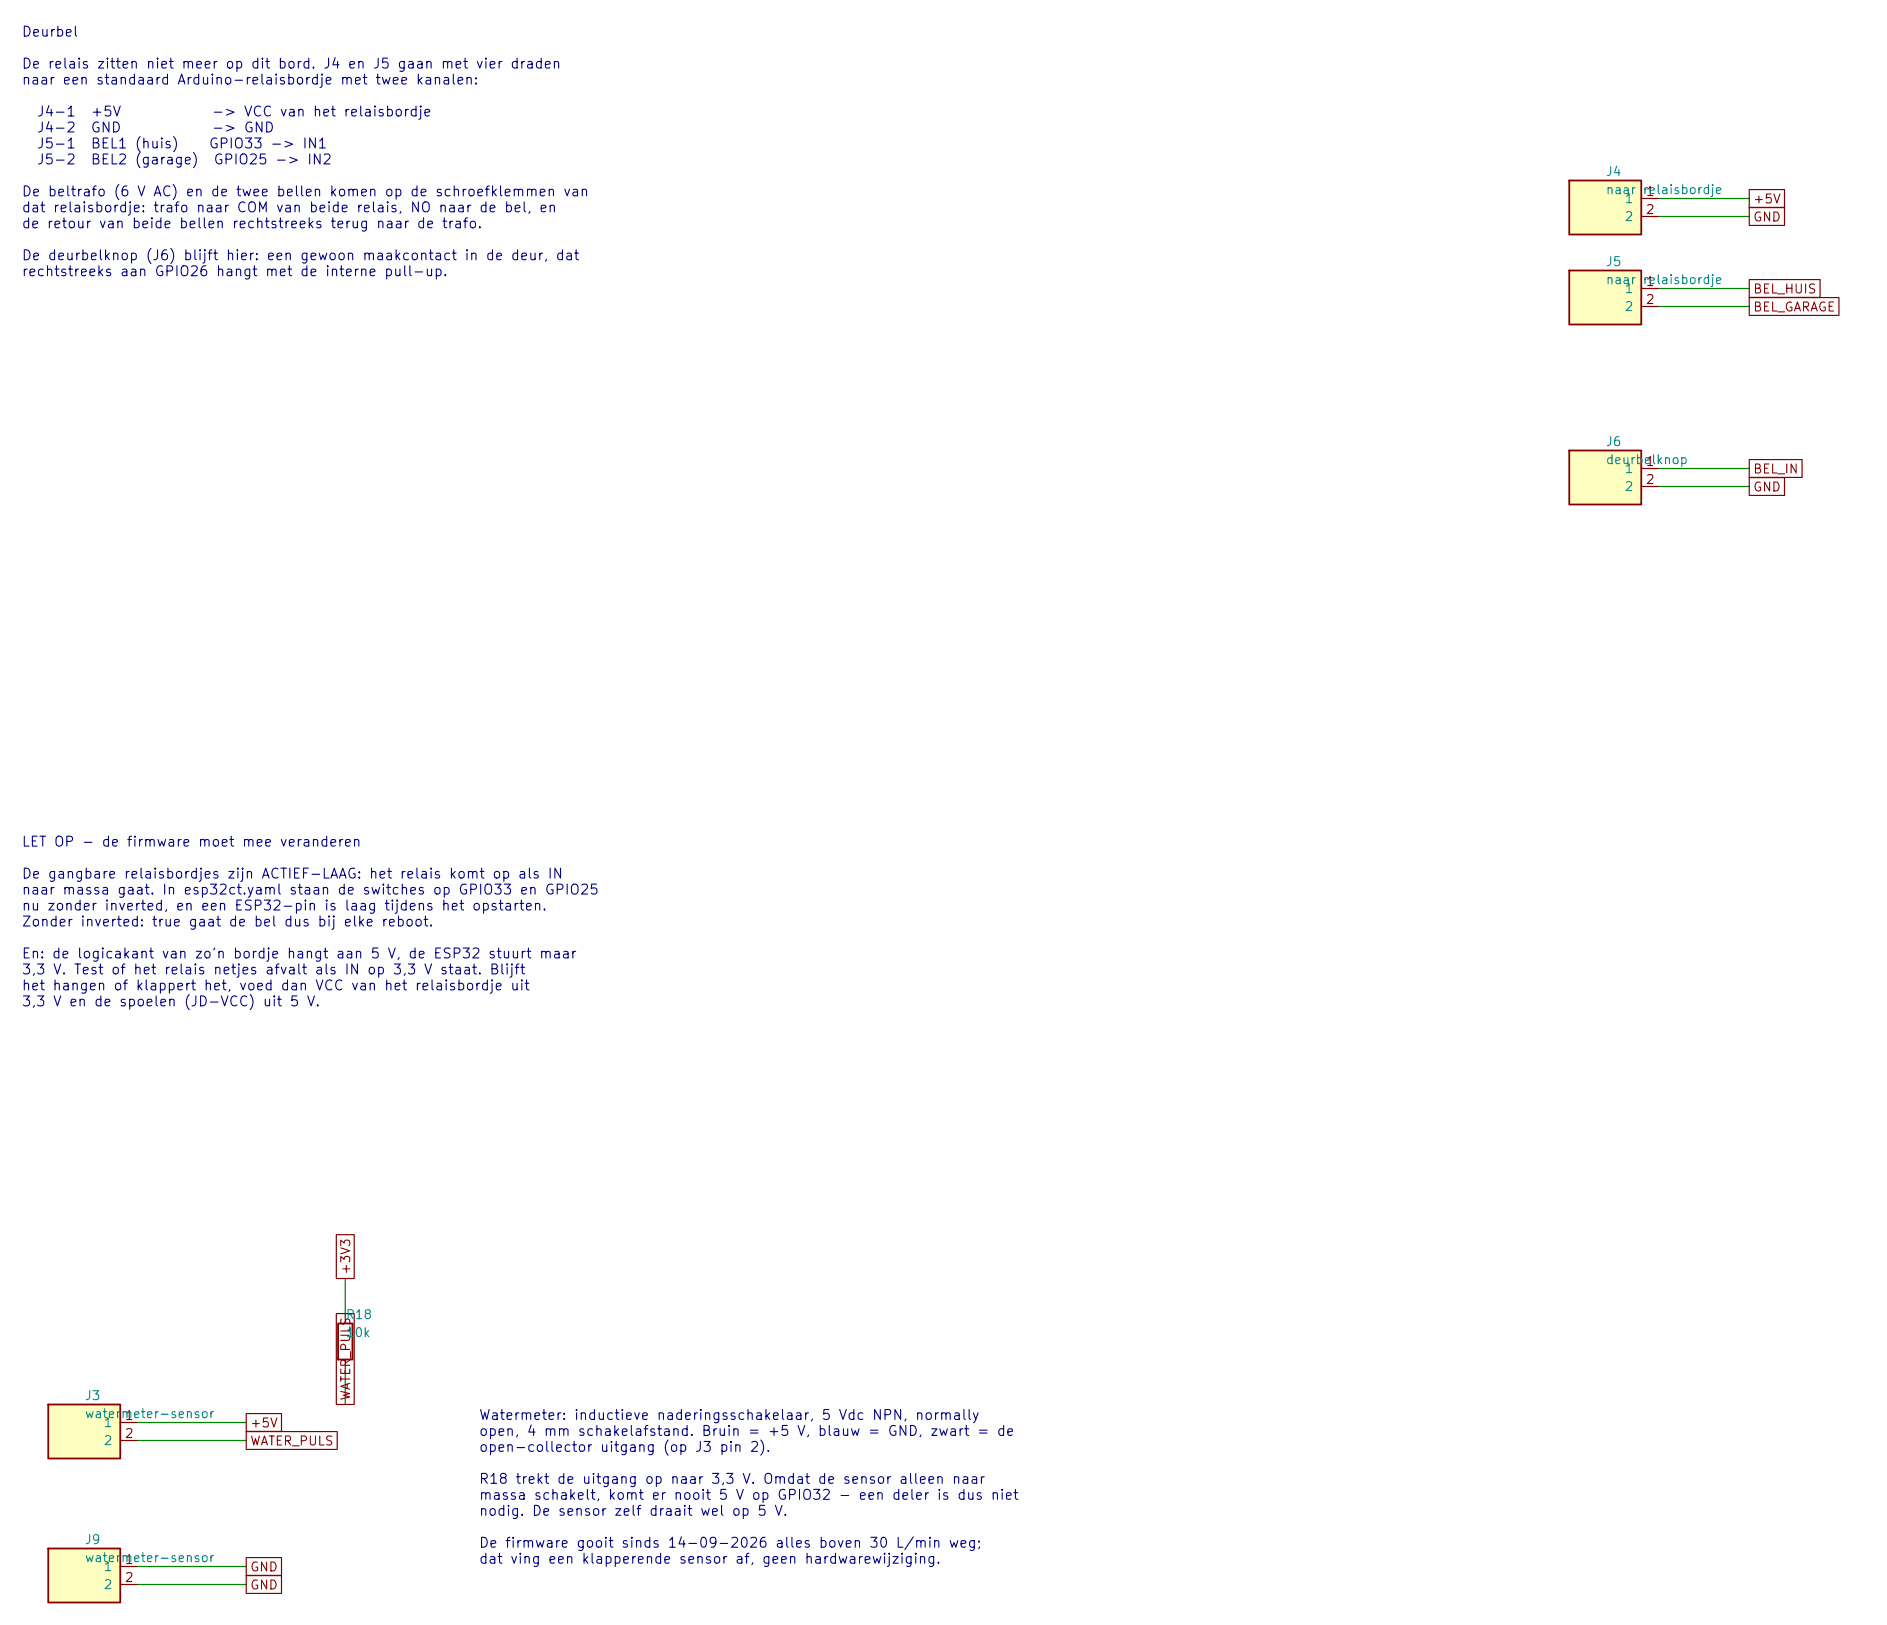
[picture p26: schematic bel_water.kicad_sch, esp32ct rev C — Deurbel en watermeter]

Parts:
J3, J9: watermeter-sensor; MX126_2P_5mm_krap
J4, J5: naar relaisbordje; MX126_2P_5mm_krap
J6: deurbelknop; MX126_2P_5mm_krap
R18: 10k; R_Axial_DIN0207_L6.3mm_D2.5mm_P10.16mm_Horizontal

Connections:
+3V3: R18.1; also elsewhere on the board
+5V: J3.1, J4.1; also elsewhere on the board
BEL_GARAGE: J5.2; also elsewhere on the board
BEL_HUIS: J5.1; also elsewhere on the board
BEL_IN: J6.1; also elsewhere on the board
GND: J4.2, J6.2, J9.1, J9.2; also elsewhere on the board
WATER_PULS: J3.2, R18.2; also elsewhere on the board

Notes on the sheet:
Watermeter: inductieve naderingsschakelaar, 5 Vdc NPN, normally open, 4 mm schakelafstand. Bruin = +5 V, blauw = GND, zwart = de open-collector uitgang (op J3 pin 2). R18 trekt de uitgang op naar 3,3 V. Omdat de sensor alleen naar massa schakelt, komt er nooit 5 V op GPIO32 - een deler is dus niet 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
Deurbel De relais zitten niet meer op dit bord. J4 en J5 gaan met vier draden naar een standaard Arduino-relaisbordje met twee kanalen: J4-1 +5V -> VCC van het relaisbordje J4-2 GND -> GND J5-1 BEL1 (huis) GPIO33 -> IN1 J5-2 BEL2 (garage) GPIO25 -> IN2 De beltrafo (6 V AC) en de twee bellen komen o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
LET OP - de firmware moet mee veranderen De gangbare relaisbordjes zijn ACTIEF-LAAG: het relais komt op als IN naar massa gaat. In esp32ct.yaml staan de switches op GPIO33 en GPIO25 nu zonder inverted, en een ESP32-pin is laag tijdens het opstarten. Zonder inverted: true gaat de bel dus bij elke re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

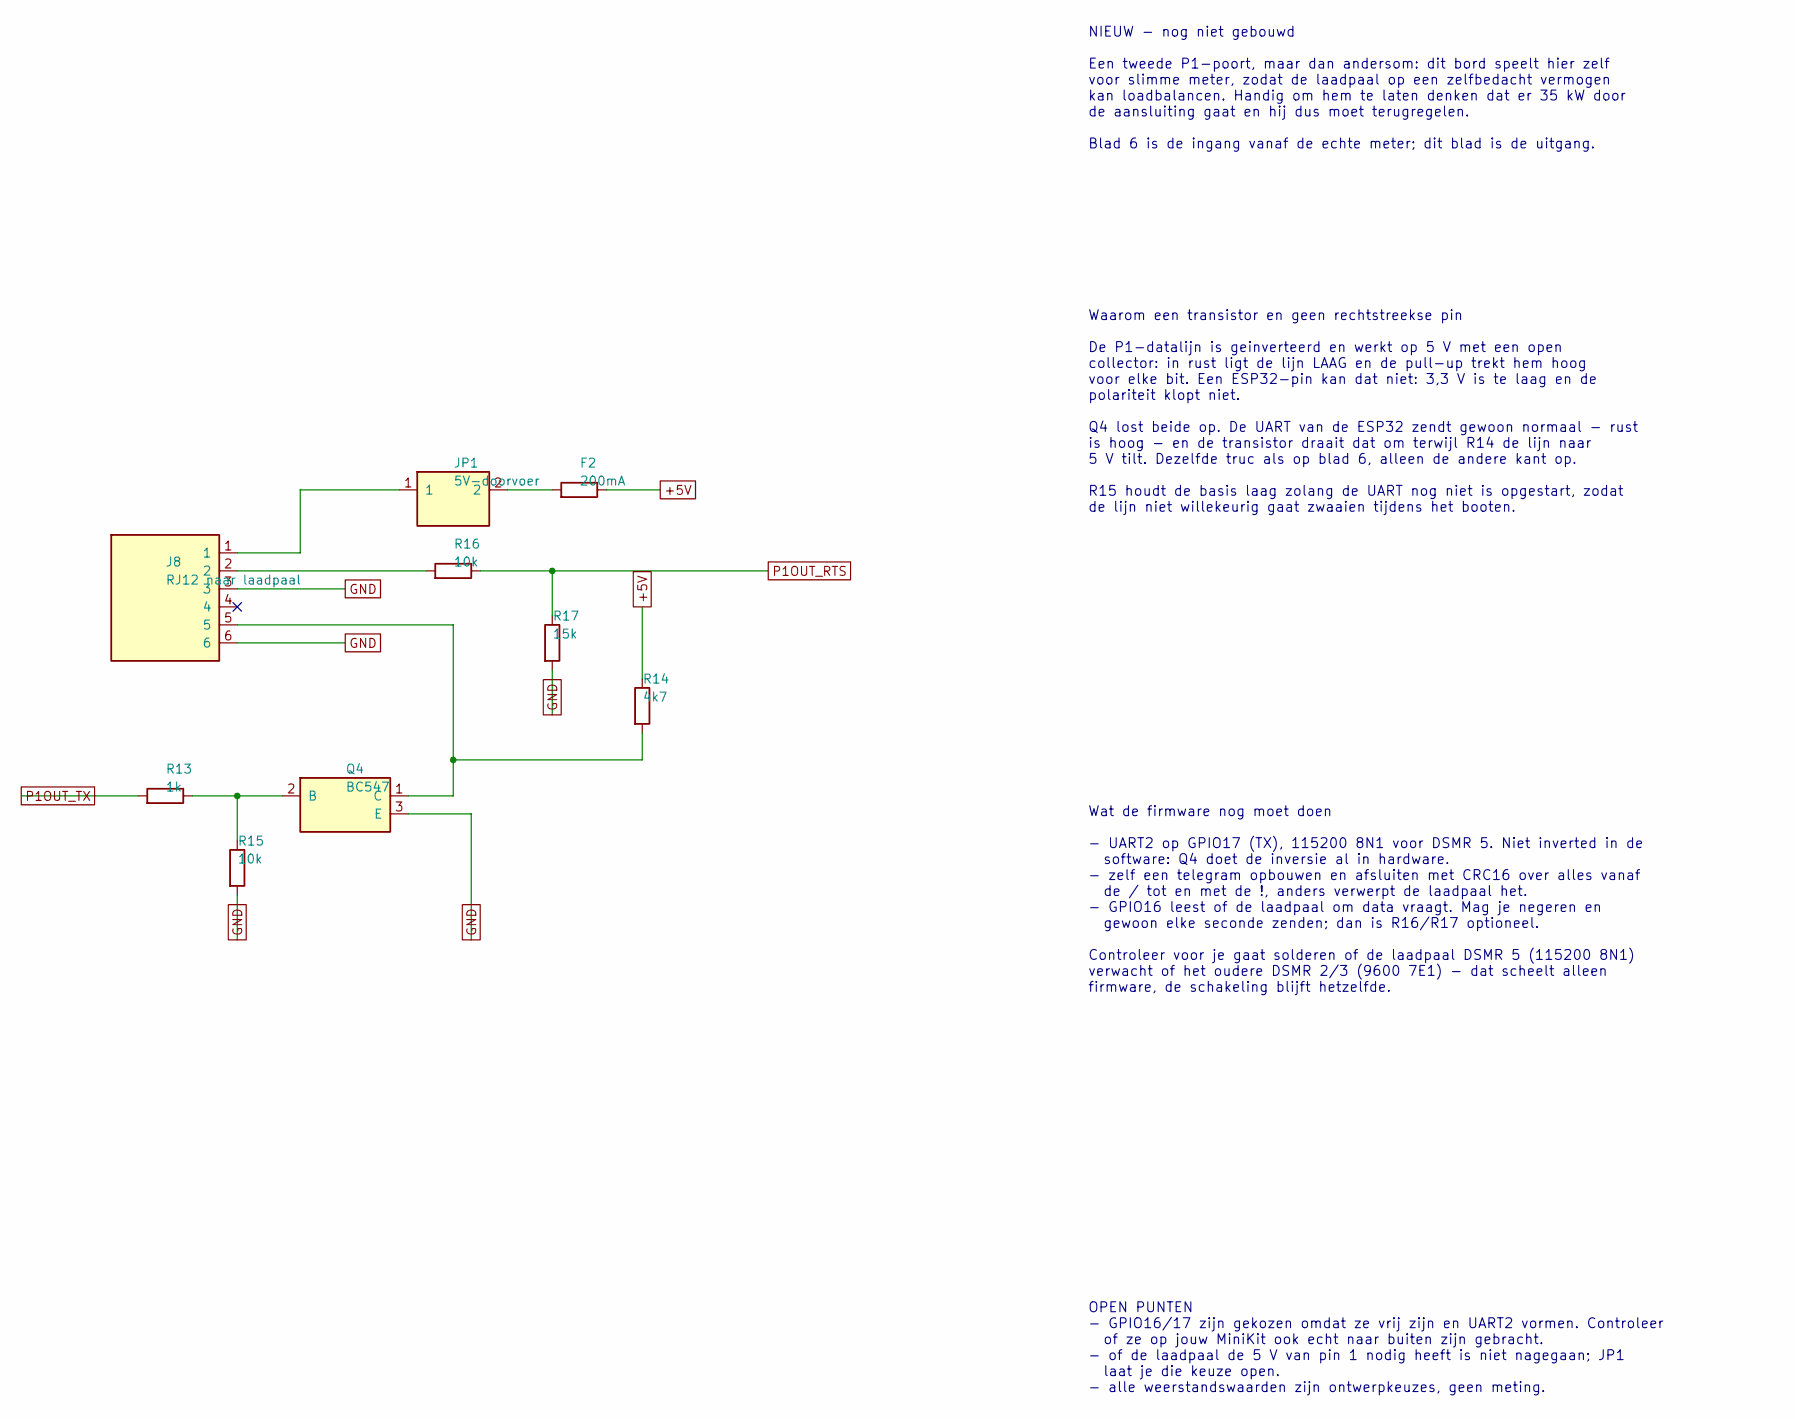
[picture p27: schematic p1_uit.kicad_sch, esp32ct rev C — P1-uitgang naar laadpaal]

Parts:
F2: 200mA; R_Axial_DIN0207_L6.3mm_D2.5mm_P10.16mm_Horizontal
J8: RJ12 naar laadpaal; RJ12_Amphenol_54601-x06_Horizontal
JP1: 5V-doorvoer; PinHeader_1x02_P2.54mm_Vertical
Q4: BC547; TO-92_Inline_Wide
R13: 1k; R_Axial_DIN0207_L6.3mm_D2.5mm_P10.16mm_Horizontal
R14: 4k7; R_Axial_DIN0207_L6.3mm_D2.5mm_P10.16mm_Horizontal
R15, R16: 10k; R_Axial_DIN0207_L6.3mm_D2.5mm_P10.16mm_Horizontal
R17: 15k; R_Axial_DIN0207_L6.3mm_D2.5mm_P10.16mm_Horizontal

Connections:
+5V: F2.2, R14.1; also elsewhere on the board
GND: J8.3, J8.6, Q4.3 (E), R15.2, R17.2; also elsewhere on the board
unnamed: F2.1, JP1.2
unnamed: J8.1, JP1.1
unnamed: J8.2, R16.1
unnamed: Q4.2 (B), R13.2, R15.1
unnamed: J8.5, Q4.1 (C), R14.2
P1OUT_RTS: R16.2, R17.1; also elsewhere on the board
P1OUT_TX: R13.1; also elsewhere on the board

Notes on the sheet:
NIEUW - nog niet gebouwd Een tweede P1-poort, maar dan andersom: dit bord speelt hier zelf voor slimme meter, zodat de laadpaal op een zelfbedacht vermogen kan loadbalancen. Handig om hem te laten denken dat er 35 kW door de aansluiting gaat en hij dus moet terugregelen. Blad 6 is de ingang vanaf d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
Waarom een transistor en geen rechtstreekse pin De P1-datalijn is geinverteerd en werkt op 5 V met een open collector: in rust ligt de lijn LAAG en de pull-up trekt hem hoog voor elke bit. Een ESP32-pin kan dat niet: 3,3 V is te laag en de polariteit klopt niet. Q4 lost beide op. De UART van de ESP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
Wat de firmware nog moet doen - UART2 op GPIO17 (TX), 115200 8N1 voor DSMR 5. Niet inverted in de software: Q4 doet de inversie al in hardware. - zelf een telegram opbouwen en afsluiten met CRC16 over alles vanaf de / tot en met de !, anders verwerpt de laadpaal het. - GPIO16 leest of de laadpaal o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
OPEN PUNTEN - GPIO16/17 zijn gekozen omdat ze vrij zijn en UART2 vormen. Controleer of ze op jouw MiniKit ook echt naar buiten zijn gebracht. - of de laadpaal de 5 V van pin 1 nodig heeft is niet nagegaan; JP1 laat je die keuze open. - alle weerstandswaarden zijn ontwerpkeuzes, geen meting.
