Aapjedotinfo/esp32ct/hardware/esp32ct-revc/esp32ct-revc.kicad_pcb

## KiCad design hardware/esp32ct-revc/esp32ct-revc.kicad_pcb (continued)

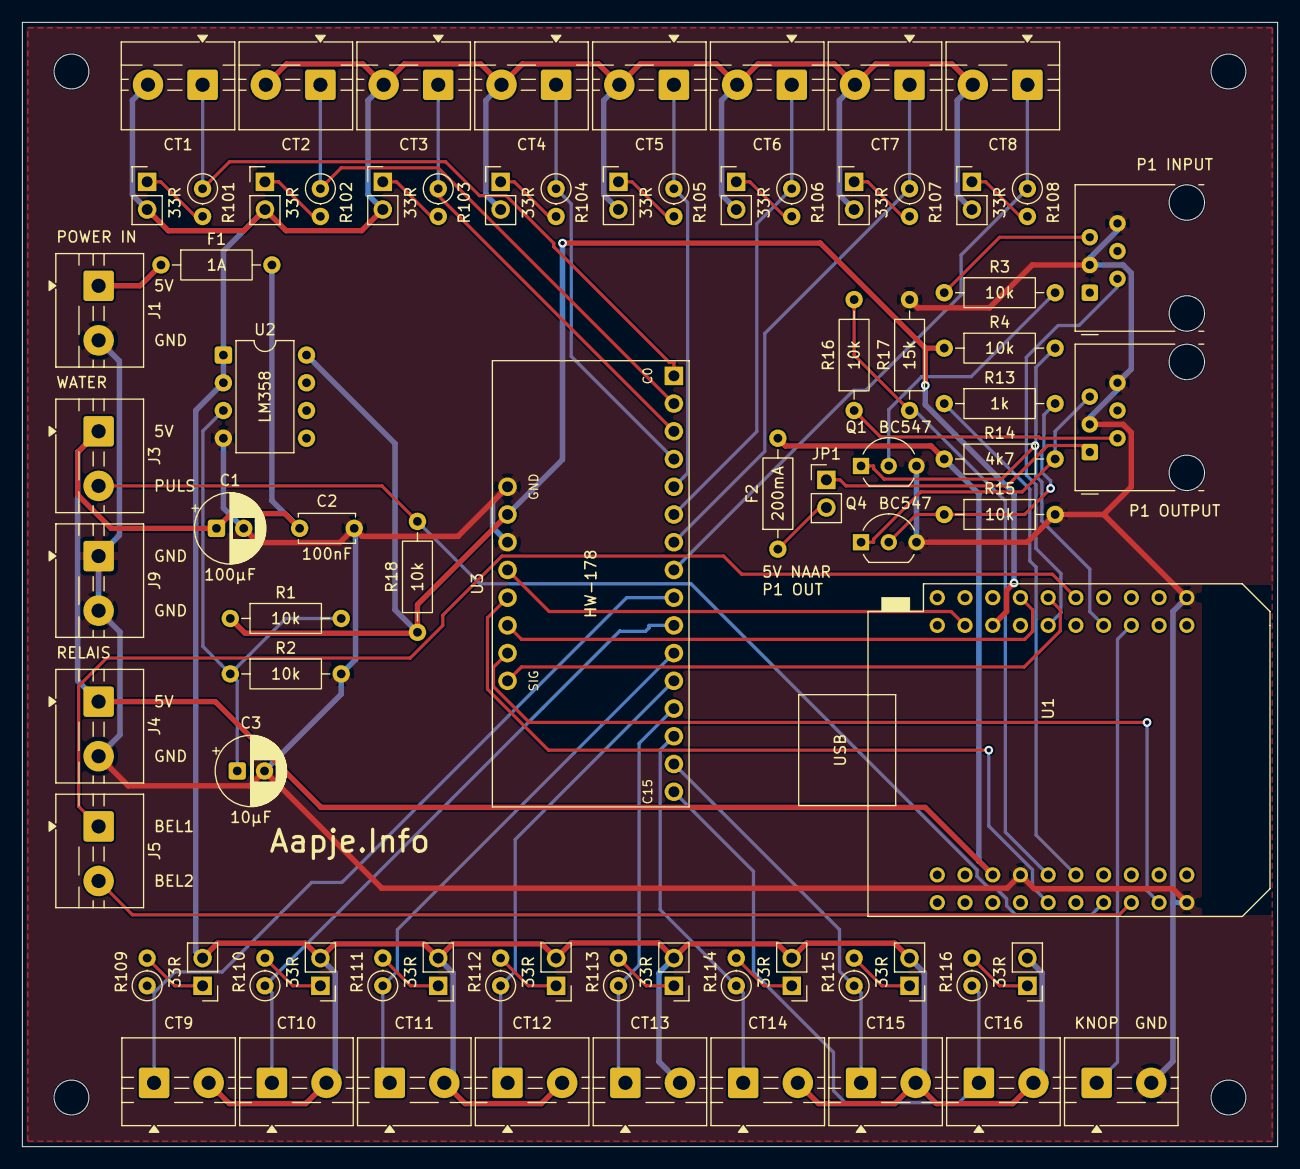
[picture p28: board esp32ct-revc.kicad_pcb from above]

Board: 2 copper layers, 115.0 x 103.0 mm, 81 parts (0 on the bottom side), 58 nets.

Other parts of the board:
H1, H2, H3, H4: M3; MountingHole_3.2mm_M3
