Aapjedotinfo/esp32ct/(notices)

Notices in the files:
README.md:
Hardware: CERN-OHL-W-2.0
